jclements3/Erand/ERAND.md

# ERAND — Erard Harp Specifications

Source: https://harpcanada.com/harpmaking/erard.htm (Joseph Jourdain, Josephus Harp Shop, 2019 analysis of a 1901 Paris drawing).

## Historical Background

- **Original drawing**: Paris, 1901, established from photographs of an Erard harp.
- **Analysis author**: Joseph Jourdain — Josephus Harp Shop (2019).
- **Period stringing**: Gut strings (nylon did not exist); compound wire strings beginning at E2 (string #36).

## Range & Configuration

| Property | Value |
|---|---|
| Total strings | 47 |
| Range | C1♭ to G7♯ |
| Middle C | String #26 (C4) |
| Visual markers | C and F strings drawn with thicker lines |

## Overall Dimensions (full-size, scaled from 1901 drawing)

| Dimension | Value |
|---|---|
| Longest string (bass) | 63.189 in |
| Spacing, first to last string | 28.224 in |
| Soundboard length | 50.972 in |
| String angle from soundboard | 34° |
| Drawing scale ratio | 5.35 |

## String Tension Assumptions

- Tensile-strength ratio: **70%** (typical of concert harps, which are known for tight strings).
- Reference string: **0.025" gut**.
- String **#6 (B6♭)** identified as the point of maximum tensile strength.

## Scale-Ratio Sample Calculations (Strings 1–10)

| # | Note | Freq (c/s) | Drawing Length | Theoretical Length | Scale Ratio |
|---|---|---:|---:|---:|---:|
| 1 | G7♭ | 2960.0 | 0.472" | 2.922" | 6.19 |
| 2 | F7♭ | 2637.0 | 0.551" | 3.280" | 5.95 |
| 3 | E7♭ | 2489.0 | 0.629" | 3.475" | 5.52 |
| 4 | D7♭ | 2217.5 | 0.708" | 3.900" | 5.51 |
| 5 | C7♭ | 1975.5 | 0.787" | 4.378" | 5.56 |
| **6** | **B6♭** | **1864.7** | **0.866"** | **4.638"** | **5.35** |
| 7 | A6♭ | 1661.2 | 0.944" | 5.207" | 5.51 |
| 8 | G6♭ | 1480.0 | 1.023" | 5.844" | 5.71 |
| 9 | F6♭ | 1318.5 | 1.141" | 6.560" | 5.75 |
| 10 | E6♭ | 1244.5 | 1.259" | 6.950" | 5.52 |

## Complete Stringing Configuration (47 strings — modern nylon/wire adaptation)

### Upper Register — Strings 1–27 (solid nylon)

| Strings | Diameter |
|---|---|
| 1–7 | 0.025" |
| 8–10 | 0.028" |
| 11 | 0.030" |
| 12–14 | 0.032" |
| 15–18 | 0.036" |
| 19–21 | 0.040" |
| 22–24 | 0.045" |
| 25–27 | 0.050" |

### Middle Register — Strings 28–38 (nylon core with nylon/steel winding)

| Strings | Nylon Core | Wire |
|---|---|---|
| 28–29 | 0.045" | 0.008" |
| 30–31 | 0.050" | 0.008" |
| 32 | 0.050" | 0.013" |
| 33–34 | 0.055" | 0.013" |
| 35–38 | 0.060" | 0.013"–0.022" |

### Lower Register — Strings 39–47 (steel core with bronze winding)

| Strings | Steel Core | Bronze Wrap |
|---|---|---|
| 39 | 0.020" | 0.008" |
| 40 | 0.020" | 0.010" |
| 41 | 0.020" | 0.010" |
| 42 | 0.022" | 0.013" |
| 43 | 0.022" | 0.013" |
| 44–47 | 0.024"–0.026" | 0.013"–0.020" |

## String Tensions

All strings are tuned to the specifications above. Tension spans from **10.976 lb** at string 1 (G7) to **52.693 lb** at string 47 (C1).

## Design Methodology (Five-Step Process)

1. Precise measurement from enlarged drawing (200%+ enlargement recommended).
2. Theoretical stringband calculation for the treble section.
3. Scale-ratio establishment via comparison method.
4. Conversion of all measurements to full size using the identified ratio.
5. Practical string-configuration planning.

### Measurement Precision

A transparent ruler with millimetre or 1/60" graduations plus a magnifying glass achieves precision of about **0.2 mm (0.008")**.

## Folk-Harp Adaptation

A 36-string folk version covering **C2 to C7** can be produced by:

- Removing the first 4 and last 7 strings.
- Converting the instrument entirely to nylon strings.
- Applying a **5.612% reduction factor** for natural notes.

## References Cited

- Melville Clark, *How to Play the Harp*.
- Roslyn Rensch, *Harps & Harpists*.
