jclements3/Erand/erand47.FCStd

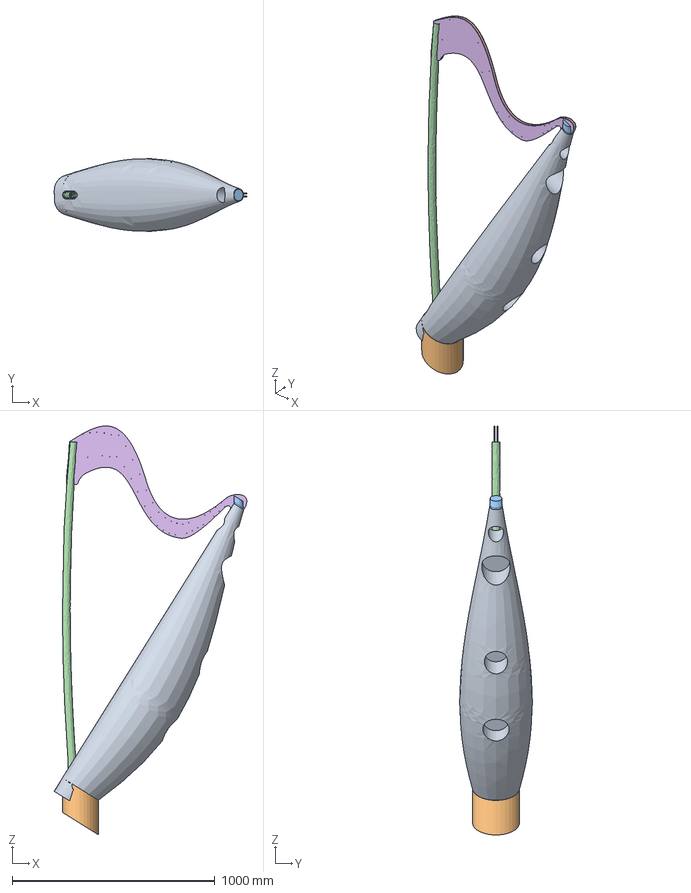
[picture p1: CAD file, 2026-04-25]
erand47.FCStd
950.1 x 359.6 x 2017.2 mm
Chamber
BasePlug
Shoulder
Column
NeckPlate_pz
NeckPlate_mz
