jclements3/Erand/soundbox/mold/individual_slabs/slab_43.dxf

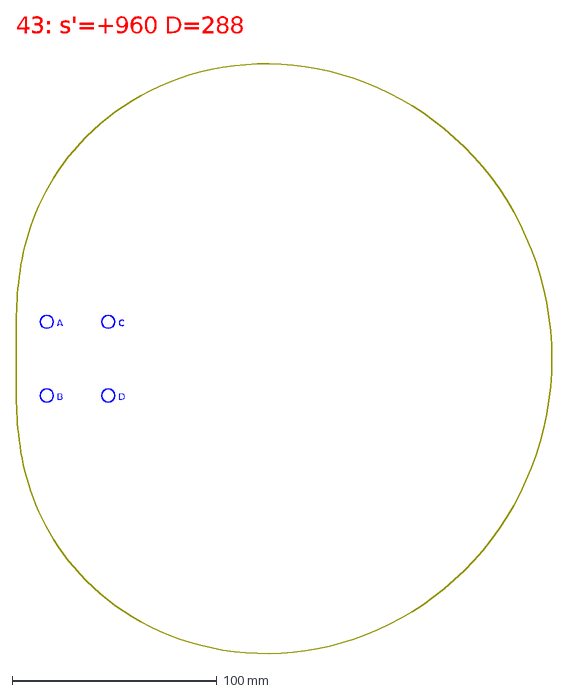
[picture p2: CAD file, 2026-04-20]
soundbox/mold/individual_slabs/slab_43.dxf
43: s'=+960 D=288
A
B
C
D
