jclements3/Erand/erand.dxf

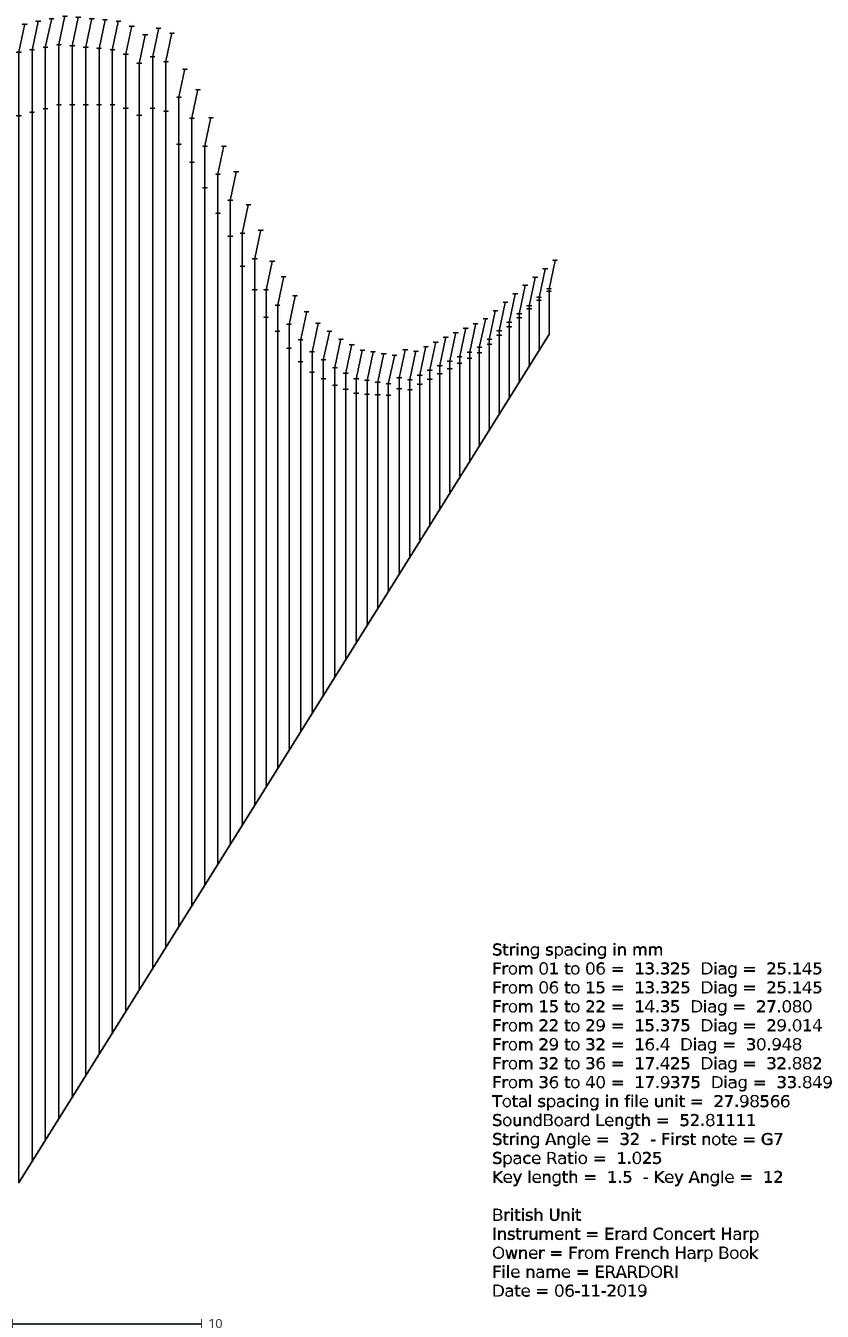
[picture p3: CAD file, 2026-04-19]
erand.dxf
String spacing in mm
From 01 to 06 = 13.325 Diag = 25.145
From 06 to 15 = 13.325 Diag = 25.145
From 15 to 22 = 14.35 Diag = 27.080
From 22 to 29 = 15.375 Diag = 29.014
From 29 to 32 = 16.4 Diag = 30.948
From 32 to 36 = 17.425 Diag = 32.882
From 36 to 40 = 17.9375 Diag = 33.849
Total spacing in file unit = 27.98566
SoundBoard Length = 52.81111
String Angle = 32 - First note = G7
Space Ratio = 1.025
Key length = 1.5 - Key Angle = 12
British Unit
Instrument = Erard Concert Harp
Owner = From French Harp Book
File name = ERARDORI
Date = 06-11-2019
