jclements3/Erand/soundbox/mold/individual_slabs/slab_67.dxf

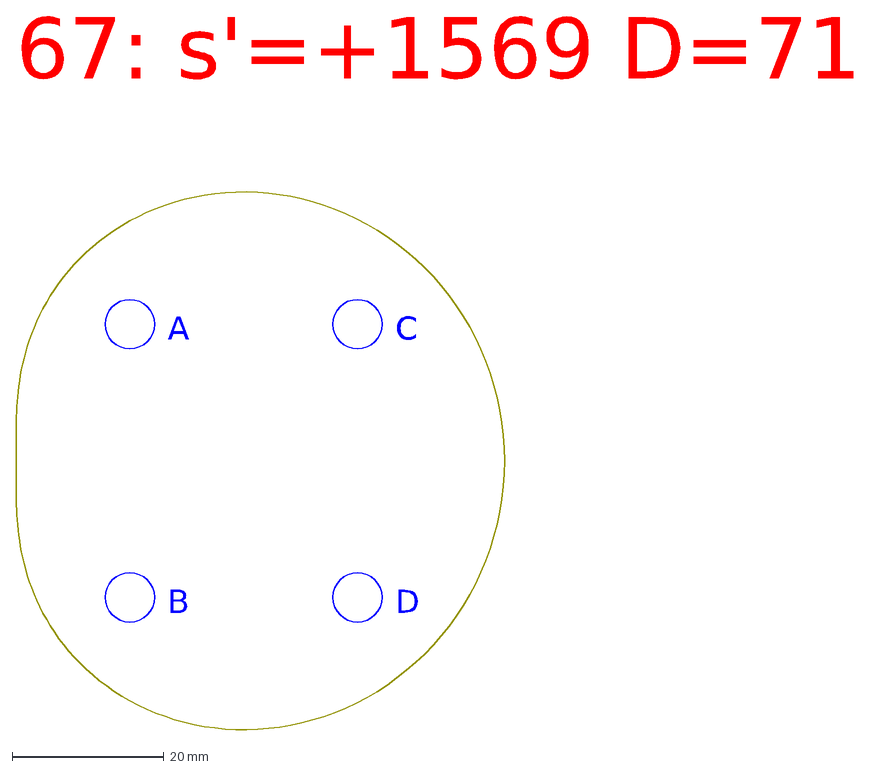
[picture p4: CAD file, 2026-04-20]
soundbox/mold/individual_slabs/slab_67.dxf
67: s'=+1569 D=71
A
B
C
D
