jclements3/Erand/soundbox/mold/individual_slabs/slab_23.dxf

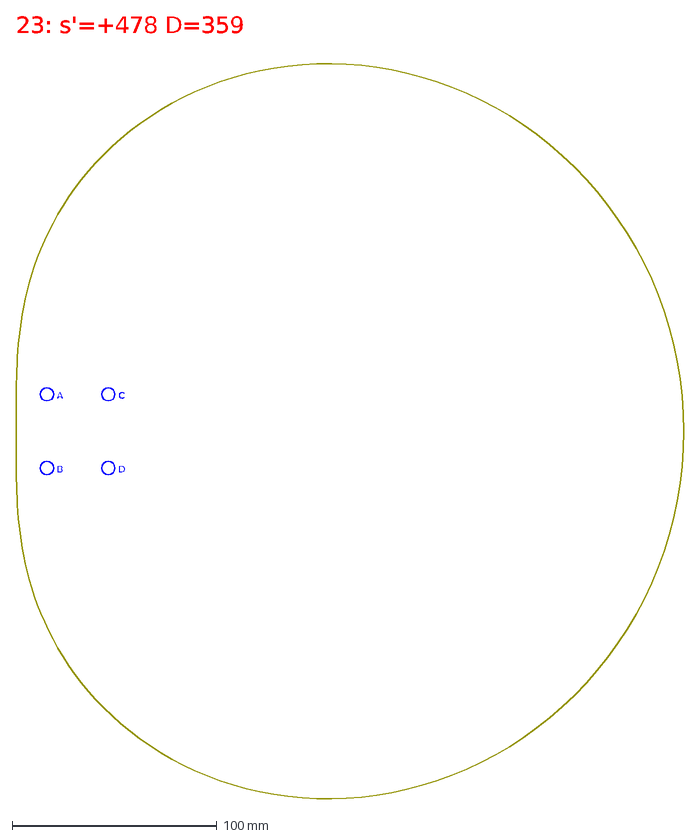
[picture p5: CAD file, 2026-04-20]
soundbox/mold/individual_slabs/slab_23.dxf
23: s'=+478 D=359
A
B
C
D
