jclements3/Erand/soundbox/mold/individual_slabs/slab_39.dxf

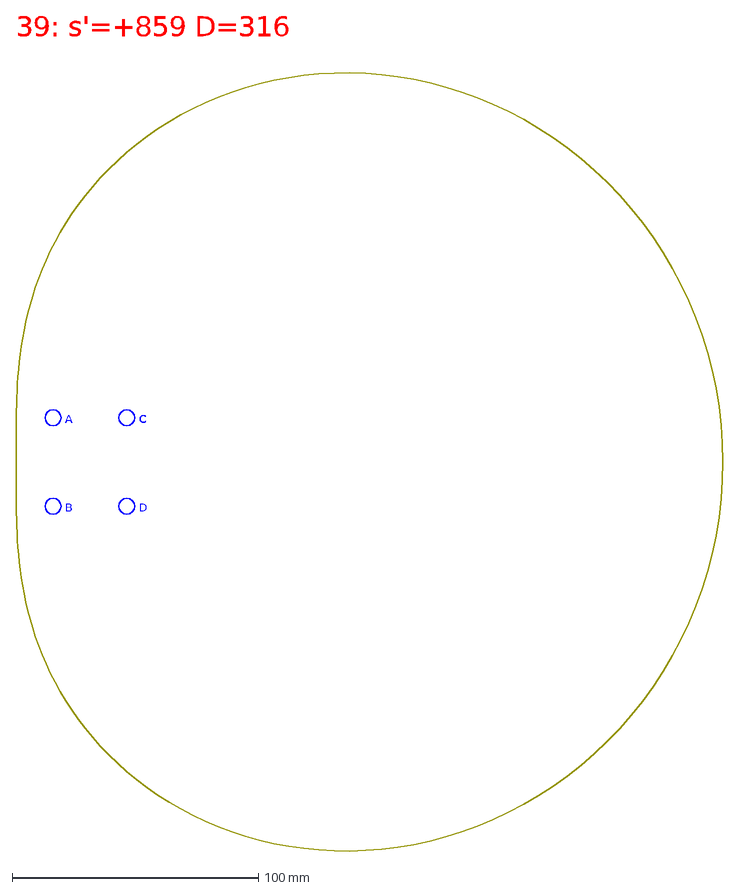
[picture p6: CAD file, 2026-04-20]
soundbox/mold/individual_slabs/slab_39.dxf
39: s'=+859 D=316
A
B
C
D
