jclements3/Erand/soundbox/mold/individual_slabs/slab_49.dxf

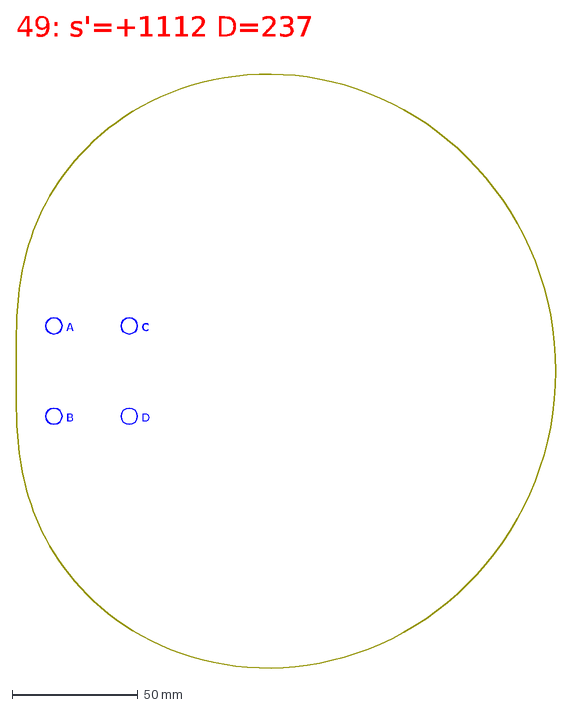
[picture p7: CAD file, 2026-04-20]
soundbox/mold/individual_slabs/slab_49.dxf
49: s'=+1112 D=237
A
B
C
D
