jclements3/Erand/soundbox/mold/individual_slabs/slab_32.dxf

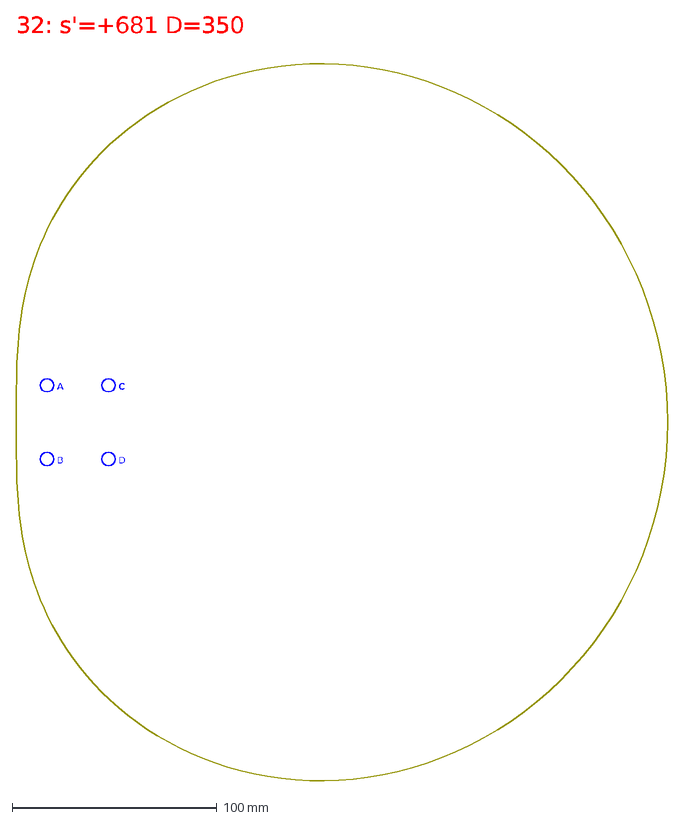
[picture p8: CAD file, 2026-04-20]
soundbox/mold/individual_slabs/slab_32.dxf
32: s'=+681 D=350
A
B
C
D
