jclements3/Erand/soundbox/mold/individual_slabs/slab_41.dxf

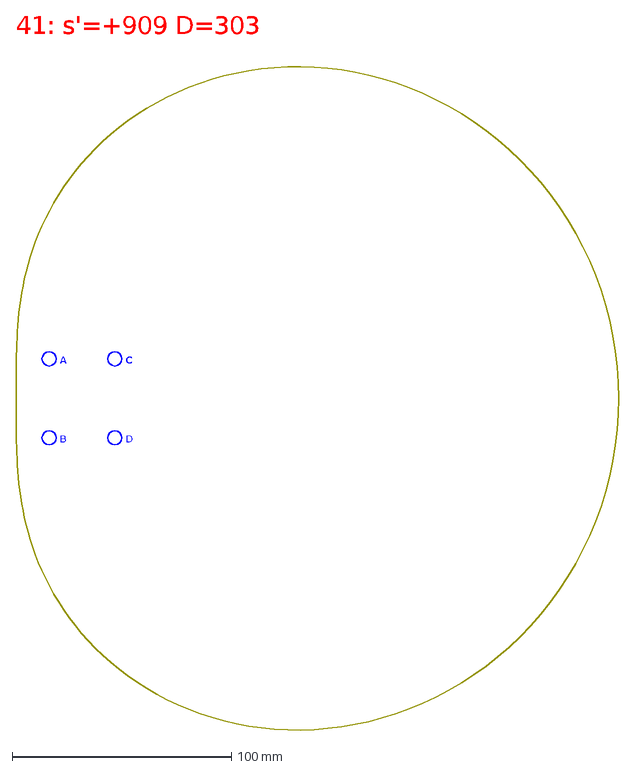
[picture p9: CAD file, 2026-04-20]
soundbox/mold/individual_slabs/slab_41.dxf
41: s'=+909 D=303
A
B
C
D
