jclements3/Erand/soundbox/mold/individual_slabs/slab_00.dxf

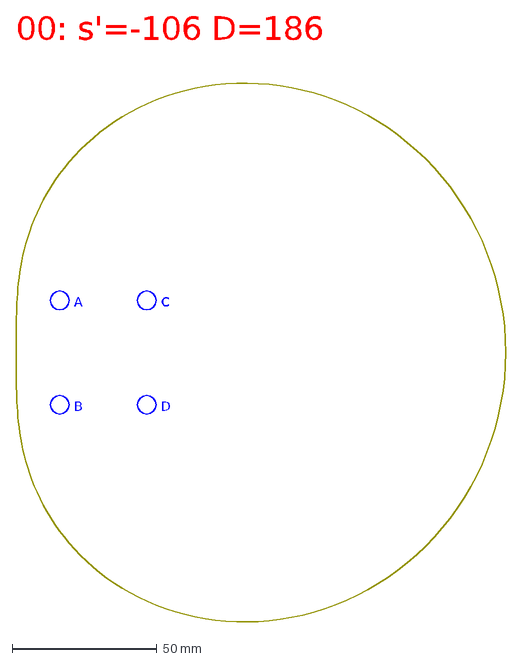
[picture p10: CAD file, 2026-04-20]
soundbox/mold/individual_slabs/slab_00.dxf
00: s'=-106 D=186
A
B
C
D
