jclements3/Erand/soundbox/mold/individual_slabs/slab_37.dxf

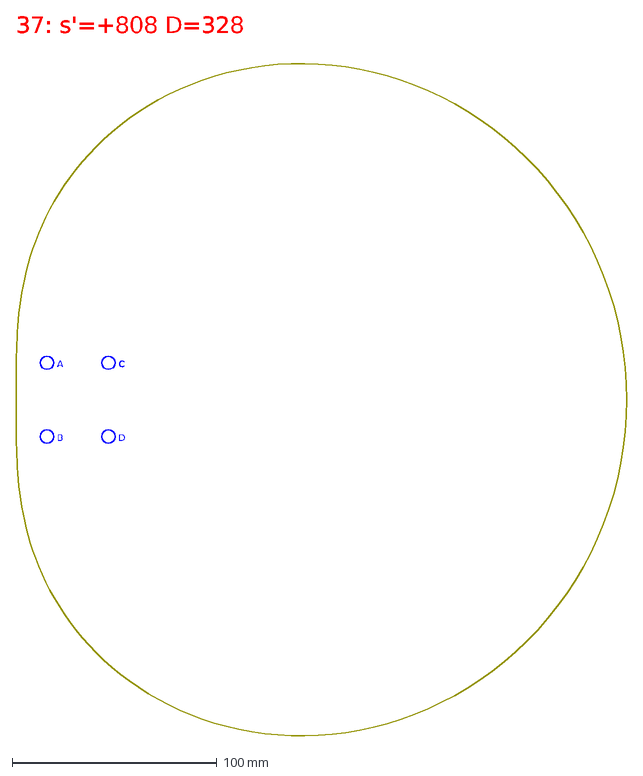
[picture p11: CAD file, 2026-04-20]
soundbox/mold/individual_slabs/slab_37.dxf
37: s'=+808 D=328
A
B
C
D
