jclements3/Erand/soundbox/mold/individual_slabs/slab_56.dxf

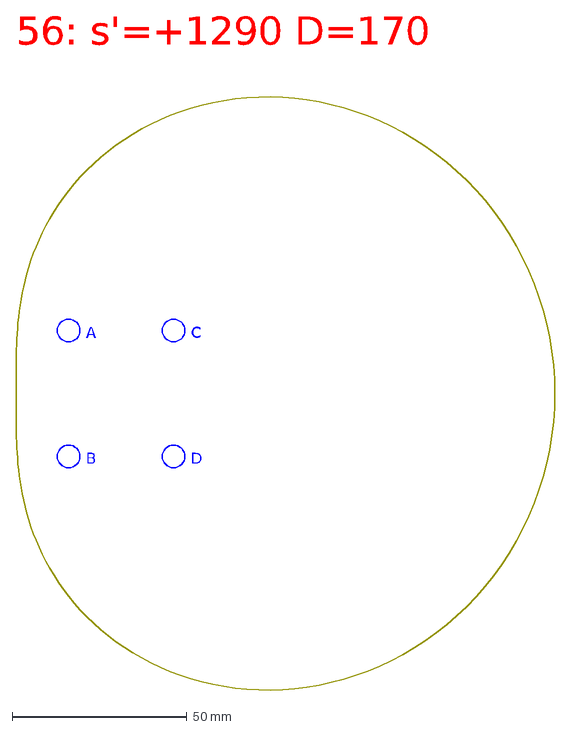
[picture p12: CAD file, 2026-04-20]
soundbox/mold/individual_slabs/slab_56.dxf
56: s'=+1290 D=170
A
B
C
D
