jclements3/Erand/soundbox/mold/individual_slabs/slab_50.dxf

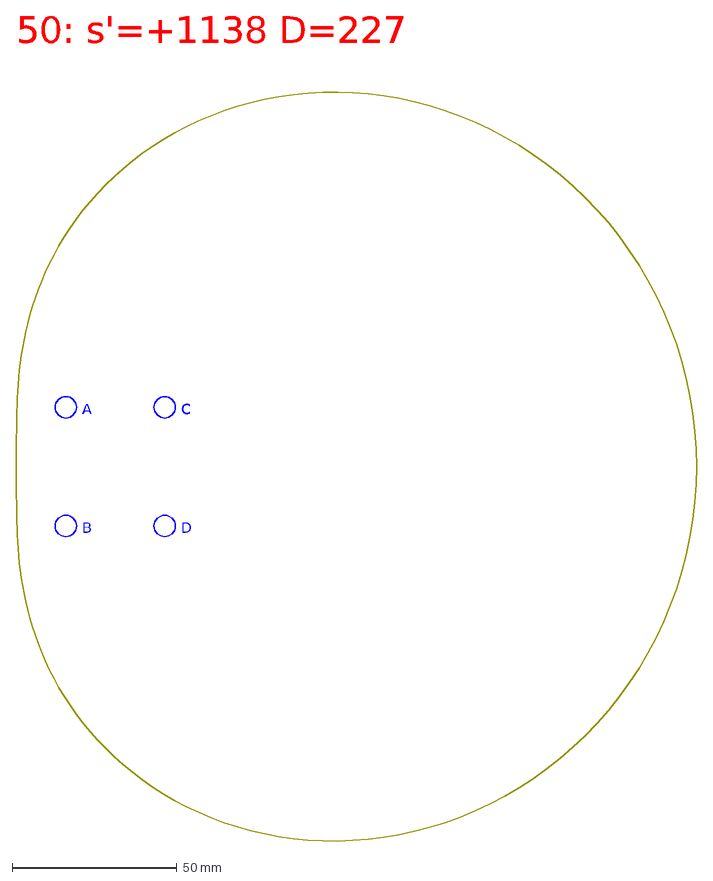
[picture p13: CAD file, 2026-04-20]
soundbox/mold/individual_slabs/slab_50.dxf
50: s'=+1138 D=227
A
B
C
D
