jclements3/Erand/soundbox/mold/individual_slabs/slab_48.dxf

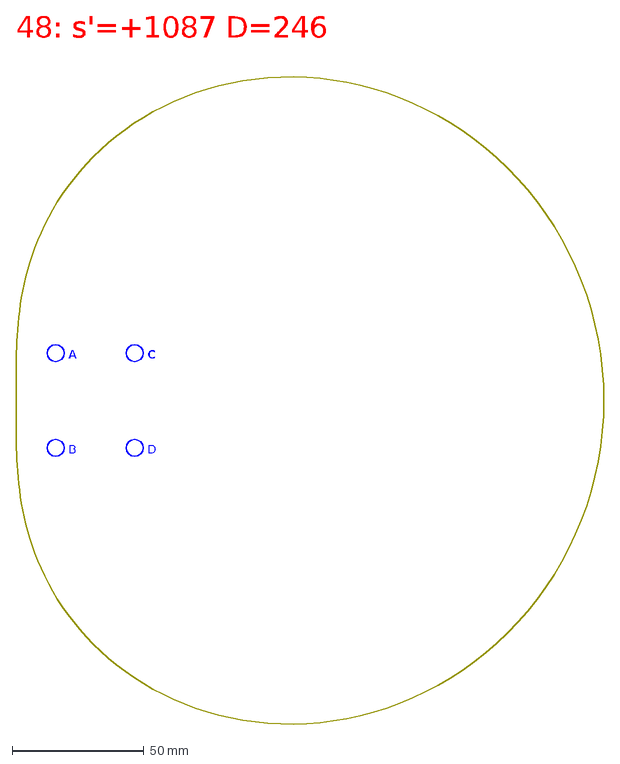
[picture p14: CAD file, 2026-04-20]
soundbox/mold/individual_slabs/slab_48.dxf
48: s'=+1087 D=246
A
B
C
D
