jclements3/Erand/soundbox/mold/individual_slabs/slab_33.dxf

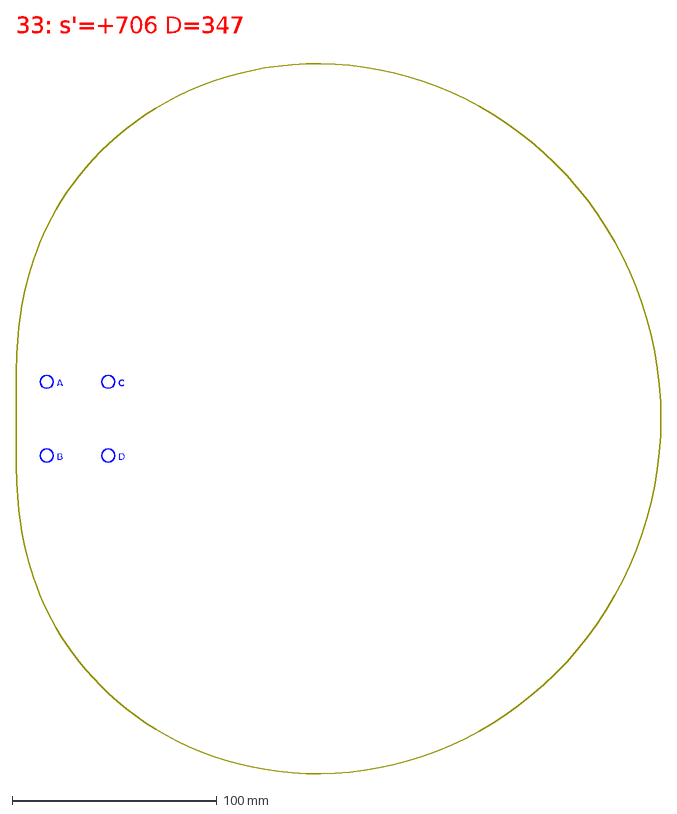
[picture p15: CAD file, 2026-04-20]
soundbox/mold/individual_slabs/slab_33.dxf
33: s'=+706 D=347
A
B
C
D
