jclements3/Erand/soundbox/mold/individual_slabs/slab_17.dxf

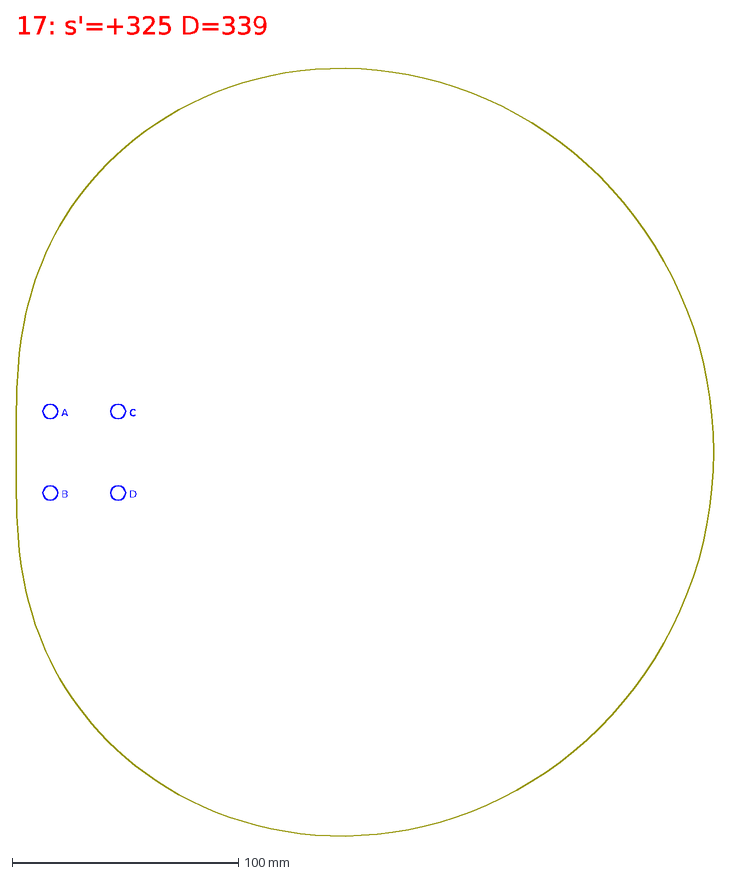
[picture p16: CAD file, 2026-04-20]
soundbox/mold/individual_slabs/slab_17.dxf
17: s'=+325 D=339
A
B
C
D
