jclements3/Erand/soundbox/mold/individual_slabs/slab_13.dxf

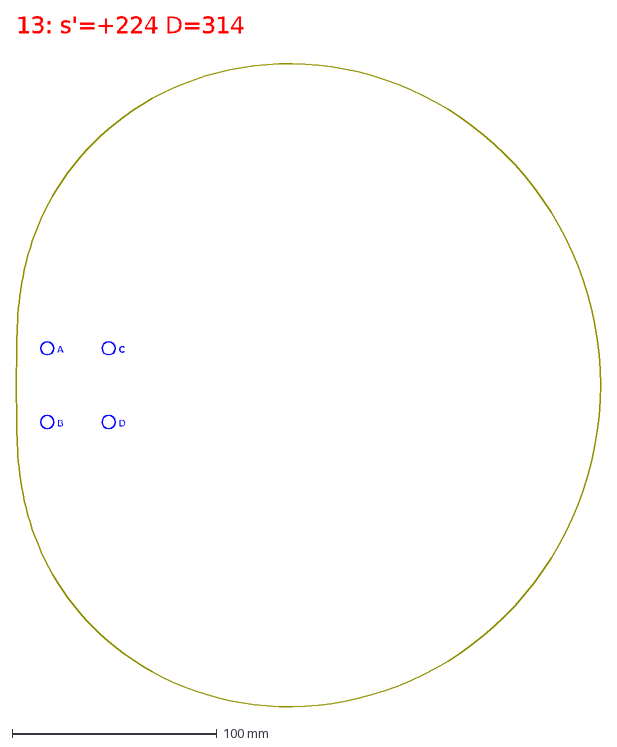
[picture p17: CAD file, 2026-04-20]
soundbox/mold/individual_slabs/slab_13.dxf
13: s'=+224 D=314
A
B
C
D
