jclements3/Erand/soundbox/mold/individual_slabs/slab_28.dxf

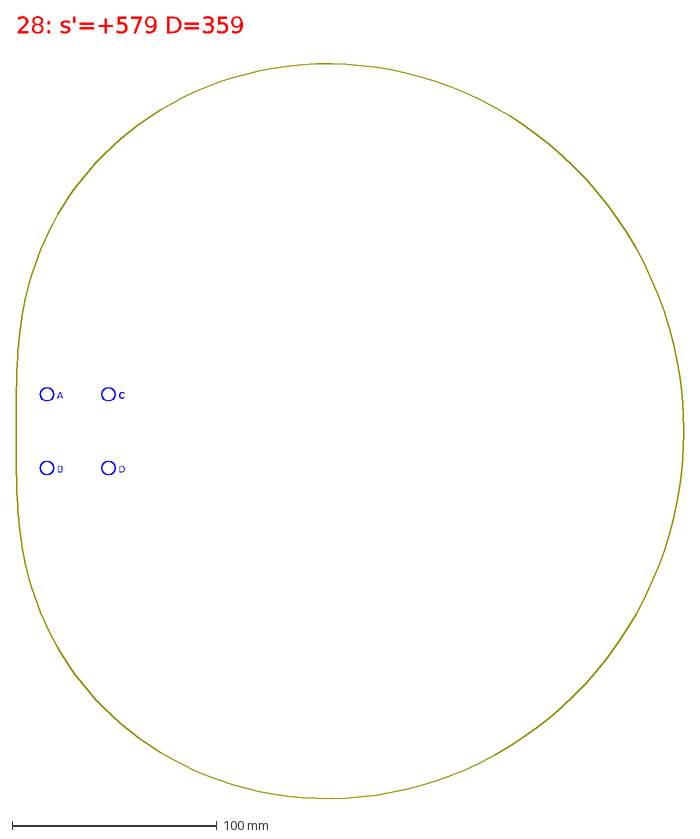
[picture p18: CAD file, 2026-04-20]
soundbox/mold/individual_slabs/slab_28.dxf
28: s'=+579 D=359
A
B
C
D
