jclements3/Erand/soundbox/mold/individual_slabs/slab_61.dxf

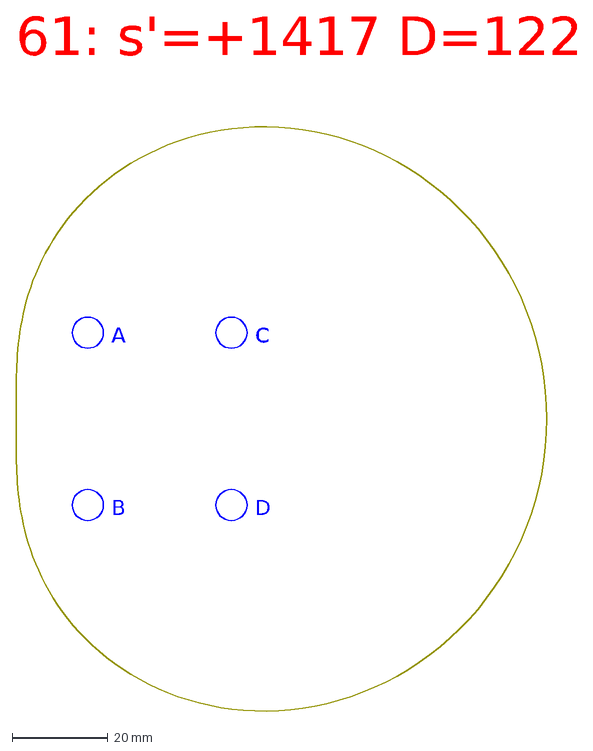
[picture p19: CAD file, 2026-04-20]
soundbox/mold/individual_slabs/slab_61.dxf
61: s'=+1417 D=122
A
B
C
D
