jclements3/Erand/soundbox/mold/individual_slabs/slab_07.dxf

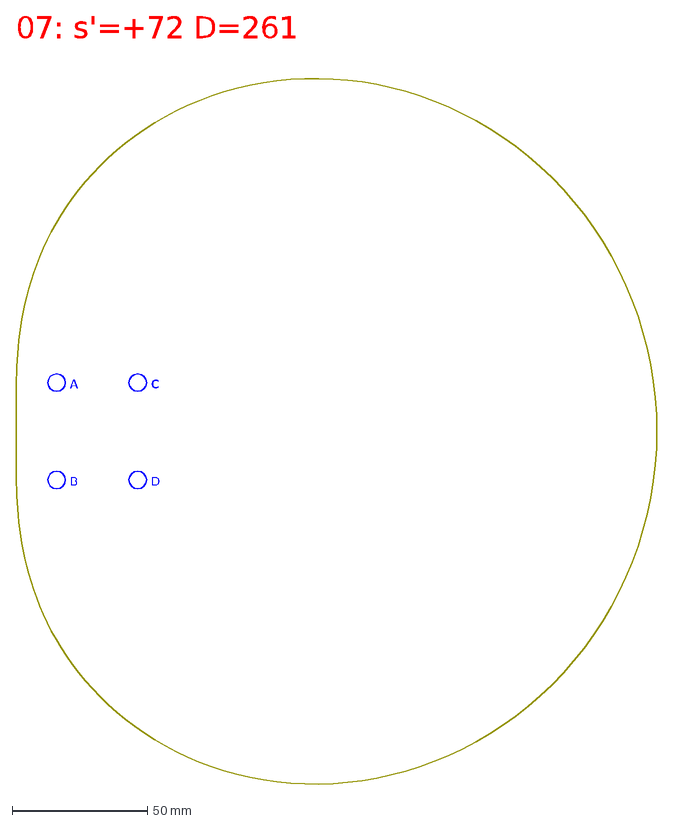
[picture p20: CAD file, 2026-04-20]
soundbox/mold/individual_slabs/slab_07.dxf
07: s'=+72 D=261
A
B
C
D
