jclements3/Erand/soundbox/mold/individual_slabs/slab_25.dxf

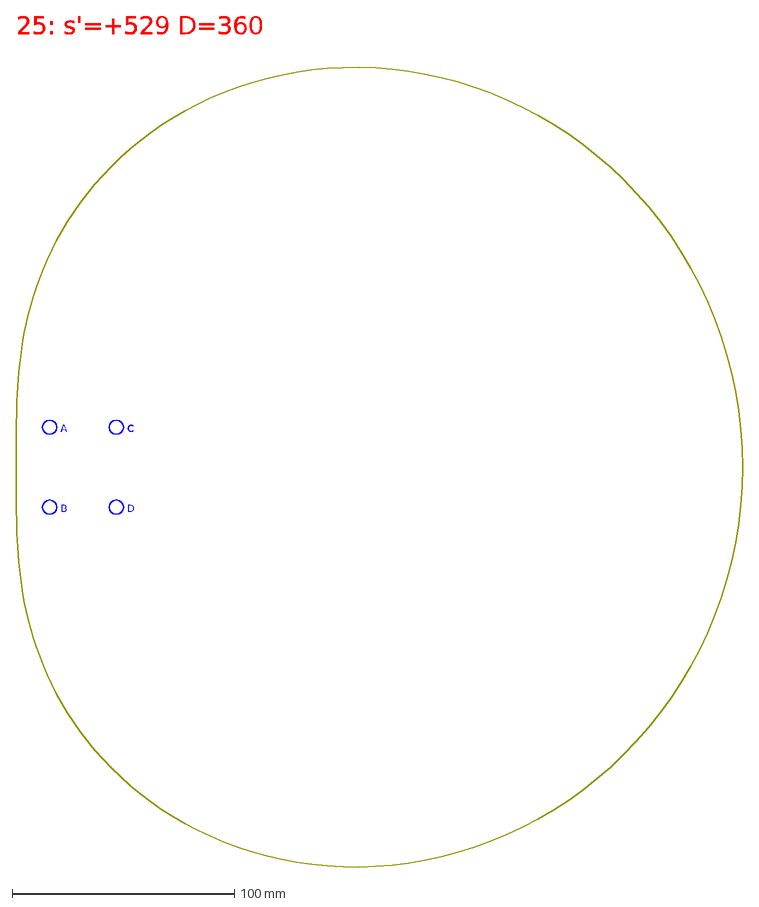
[picture p21: CAD file, 2026-04-20]
soundbox/mold/individual_slabs/slab_25.dxf
25: s'=+529 D=360
A
B
C
D
