jclements3/Erand/soundbox/mold/individual_slabs/slab_12.dxf

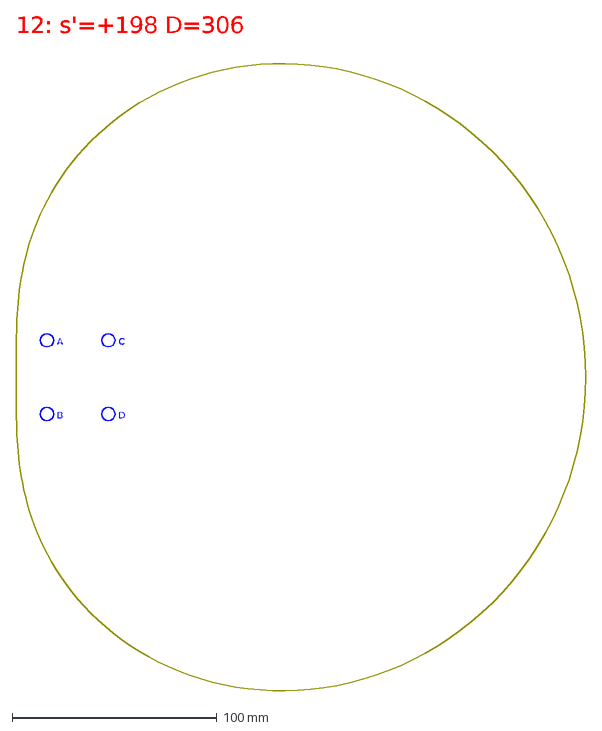
[picture p22: CAD file, 2026-04-20]
soundbox/mold/individual_slabs/slab_12.dxf
12: s'=+198 D=306
A
B
C
D
