jclements3/Erand/soundbox/mold/individual_slabs/slab_44.dxf

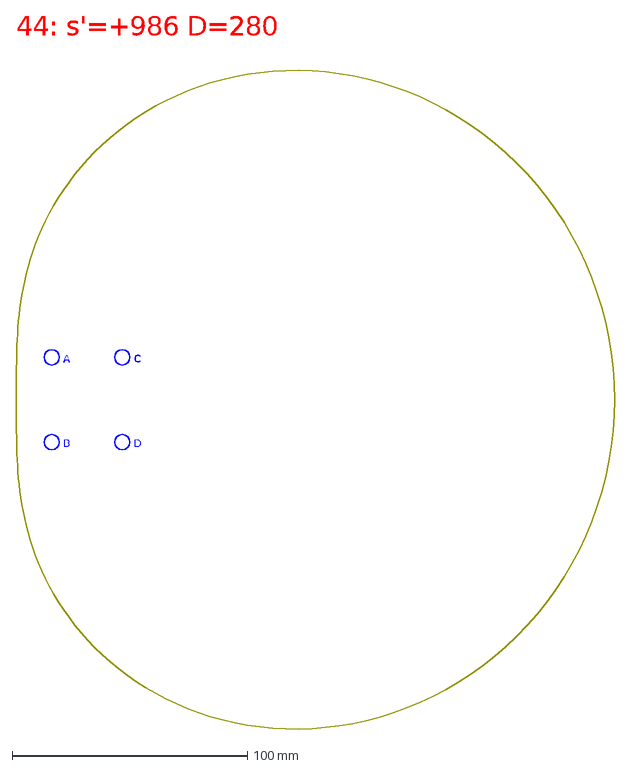
[picture p23: CAD file, 2026-04-20]
soundbox/mold/individual_slabs/slab_44.dxf
44: s'=+986 D=280
A
B
C
D
