jclements3/Erand/soundbox/mold/individual_slabs/slab_20.dxf

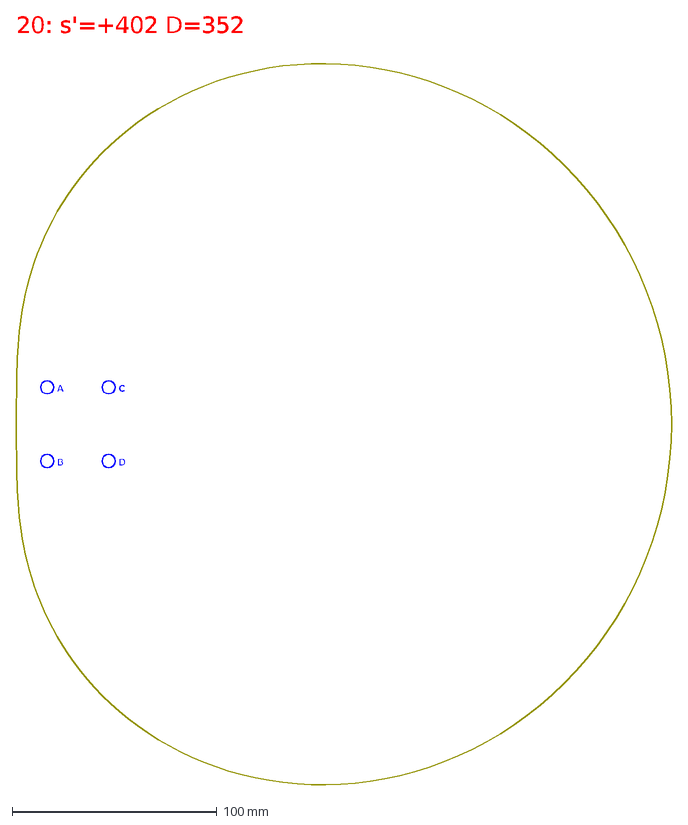
[picture p24: CAD file, 2026-04-20]
soundbox/mold/individual_slabs/slab_20.dxf
20: s'=+402 D=352
A
B
C
D
