jclements3/Erand/soundbox/mold/individual_slabs/slab_21.dxf

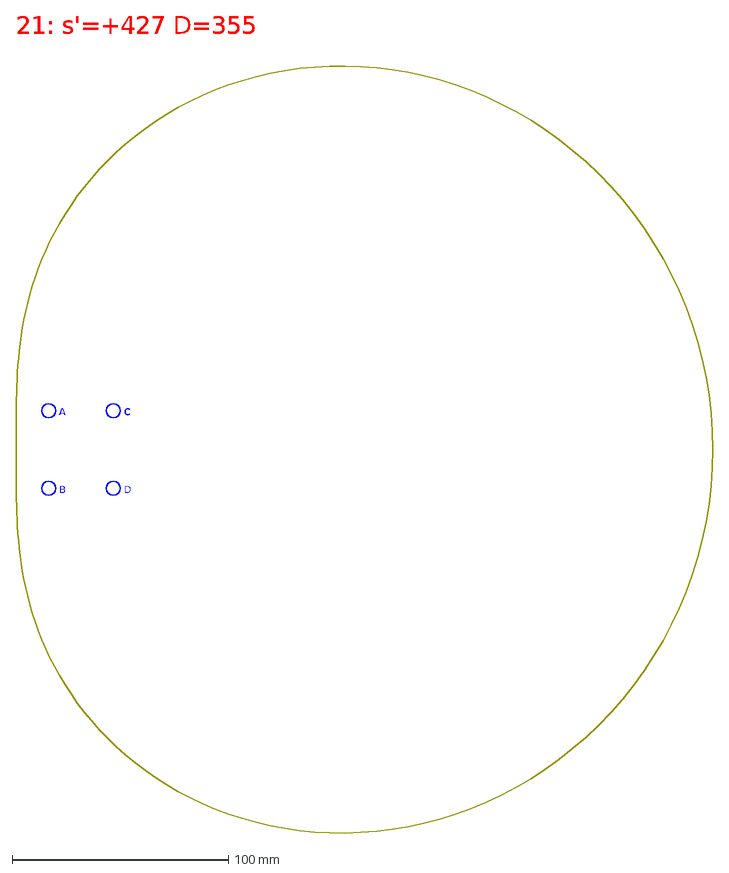
[picture p25: CAD file, 2026-04-20]
soundbox/mold/individual_slabs/slab_21.dxf
21: s'=+427 D=355
A
B
C
D
