jclements3/Erand/soundbox/mold/individual_slabs/slab_34.dxf

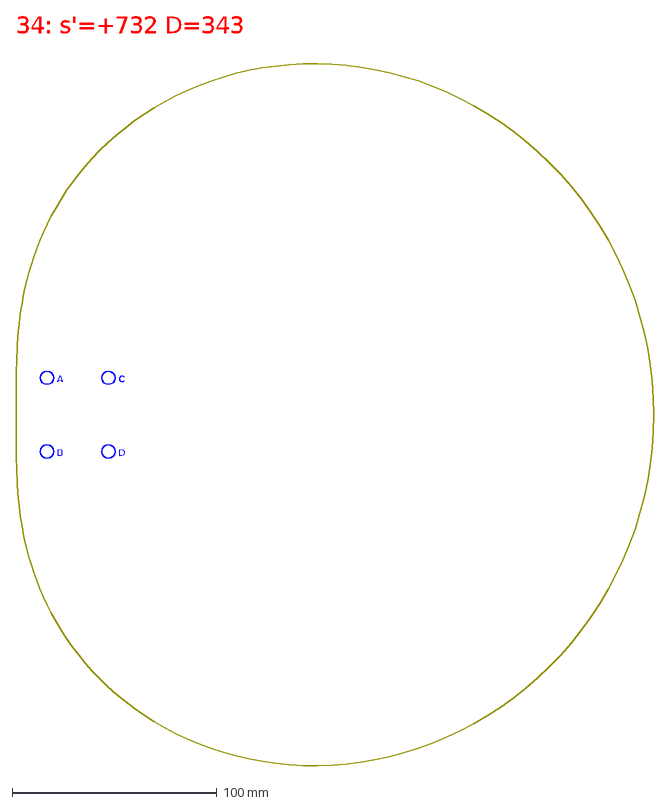
[picture p26: CAD file, 2026-04-20]
soundbox/mold/individual_slabs/slab_34.dxf
34: s'=+732 D=343
A
B
C
D
