jclements3/Erand/soundbox/mold/individual_slabs/slab_57.dxf

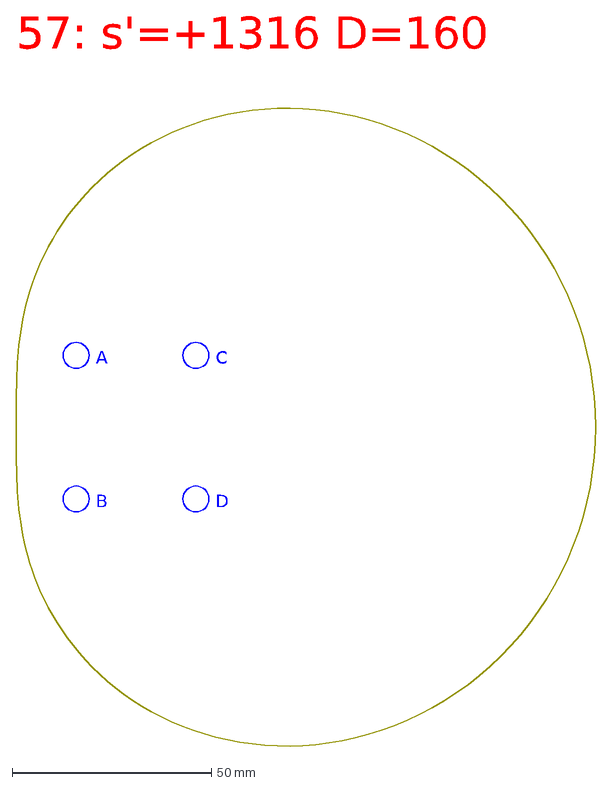
[picture p27: CAD file, 2026-04-20]
soundbox/mold/individual_slabs/slab_57.dxf
57: s'=+1316 D=160
A
B
C
D
