jclements3/Erand/soundbox/mold/individual_slabs/slab_66.dxf

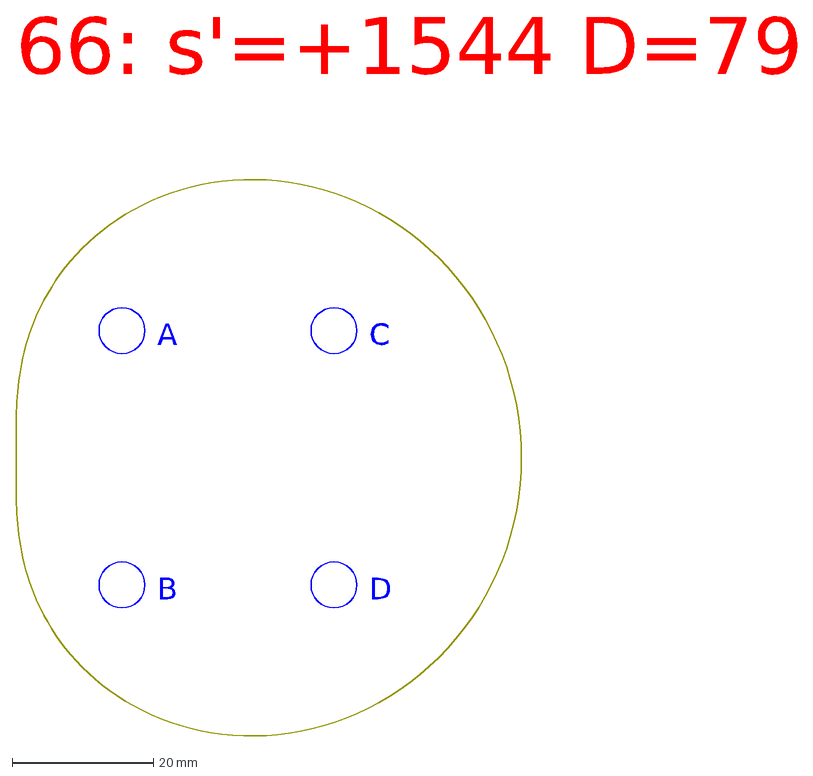
[picture p28: CAD file, 2026-04-20]
soundbox/mold/individual_slabs/slab_66.dxf
66: s'=+1544 D=79
A
B
C
D
