jclements3/Erand/soundbox/mold/individual_slabs/slab_04.dxf

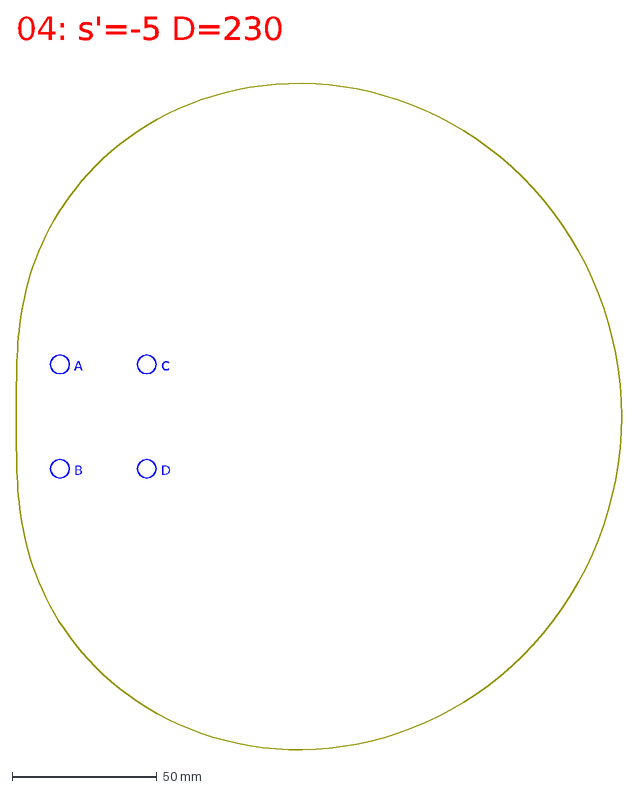
[picture p29: CAD file, 2026-04-20]
soundbox/mold/individual_slabs/slab_04.dxf
04: s'=-5 D=230
A
B
C
D
