jclements3/Erand/soundbox/mold/individual_slabs/slab_29.dxf

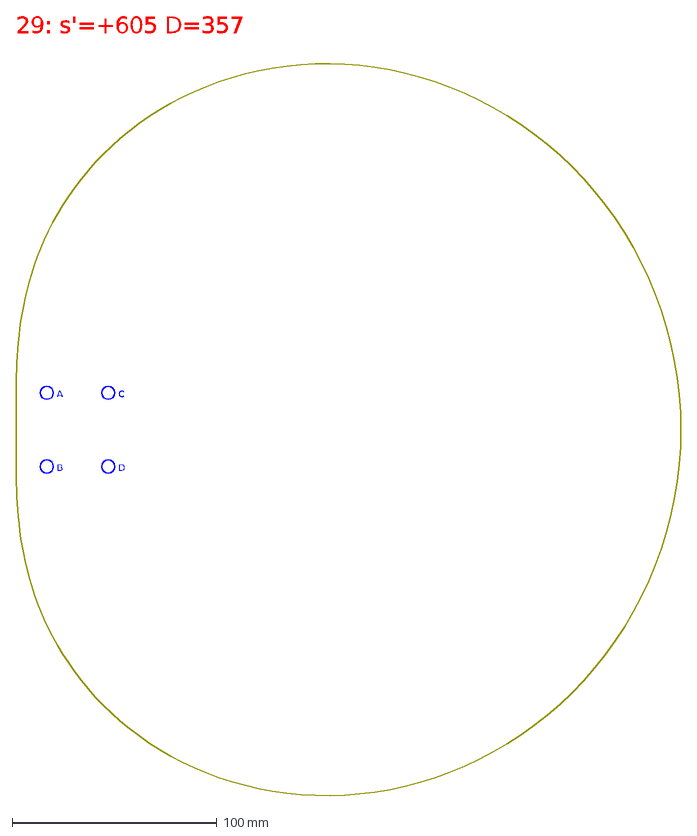
[picture p30: CAD file, 2026-04-20]
soundbox/mold/individual_slabs/slab_29.dxf
29: s'=+605 D=357
A
B
C
D
