jclements3/Erand/soundbox/mold/individual_slabs/slab_06.dxf

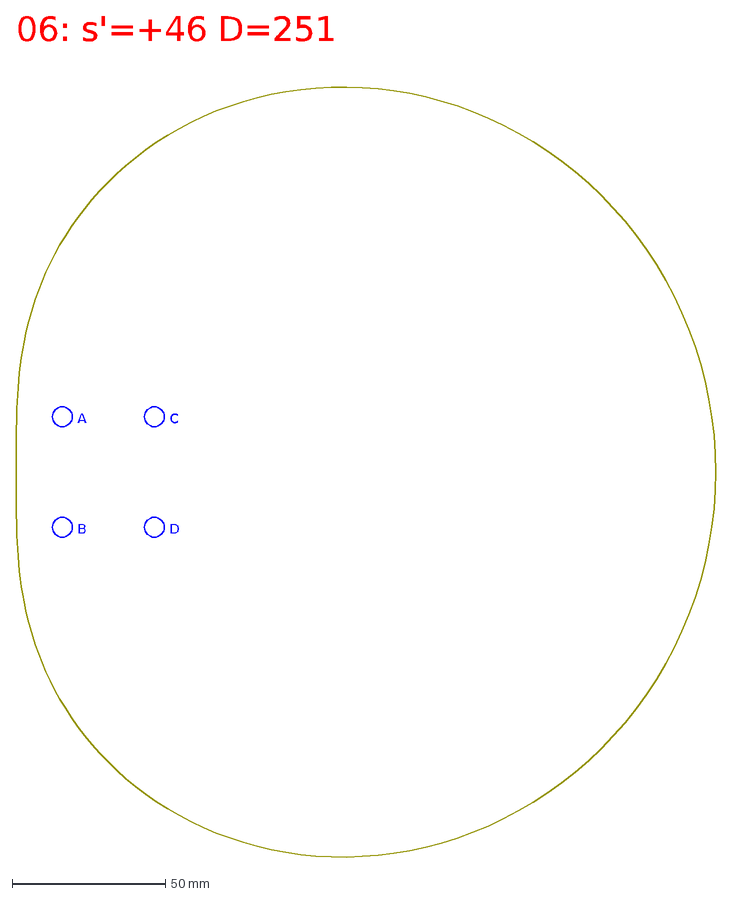
[picture p31: CAD file, 2026-04-20]
soundbox/mold/individual_slabs/slab_06.dxf
06: s'=+46 D=251
A
B
C
D
