jclements3/Erand/soundbox/mold/individual_slabs/slab_10.dxf

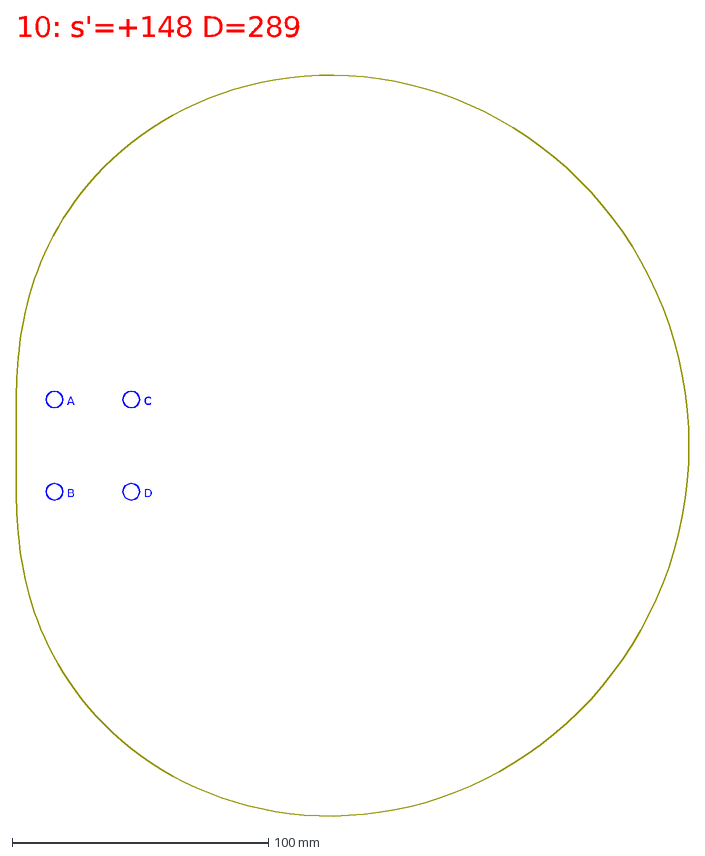
[picture p32: CAD file, 2026-04-20]
soundbox/mold/individual_slabs/slab_10.dxf
10: s'=+148 D=289
A
B
C
D
