jclements3/Erand/soundbox/mold/individual_slabs/slab_27.dxf

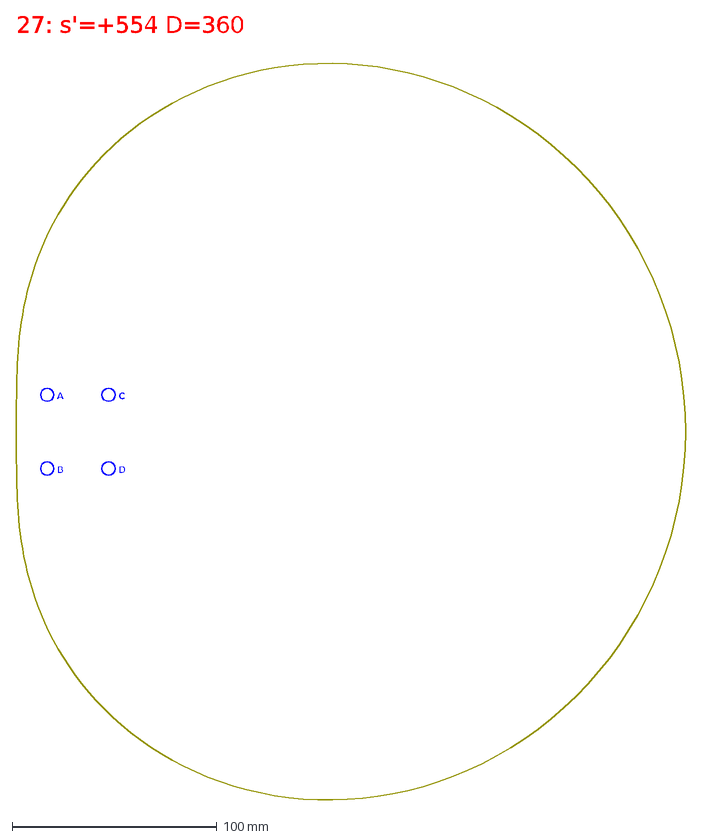
[picture p33: CAD file, 2026-04-20]
soundbox/mold/individual_slabs/slab_27.dxf
27: s'=+554 D=360
A
B
C
D
