jclements3/Erand/soundbox/mold/individual_slabs/slab_05.dxf

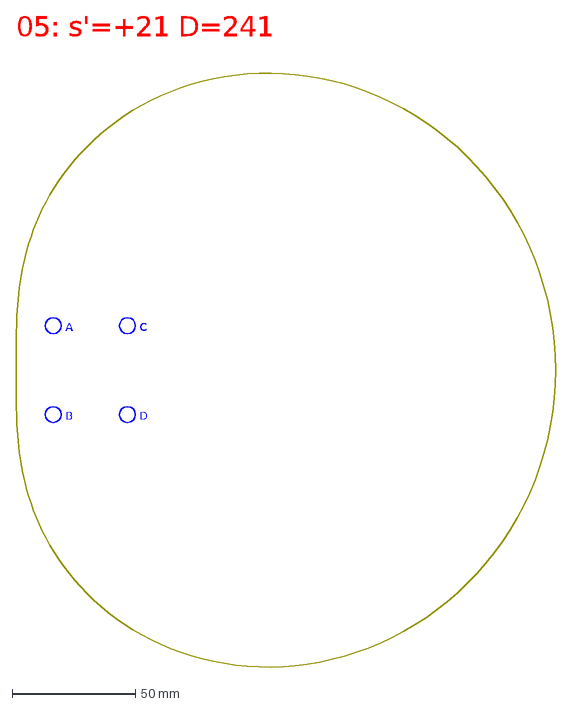
[picture p34: CAD file, 2026-04-20]
soundbox/mold/individual_slabs/slab_05.dxf
05: s'=+21 D=241
A
B
C
D
