jclements3/Erand/soundbox/mold/individual_slabs/slab_26.dxf

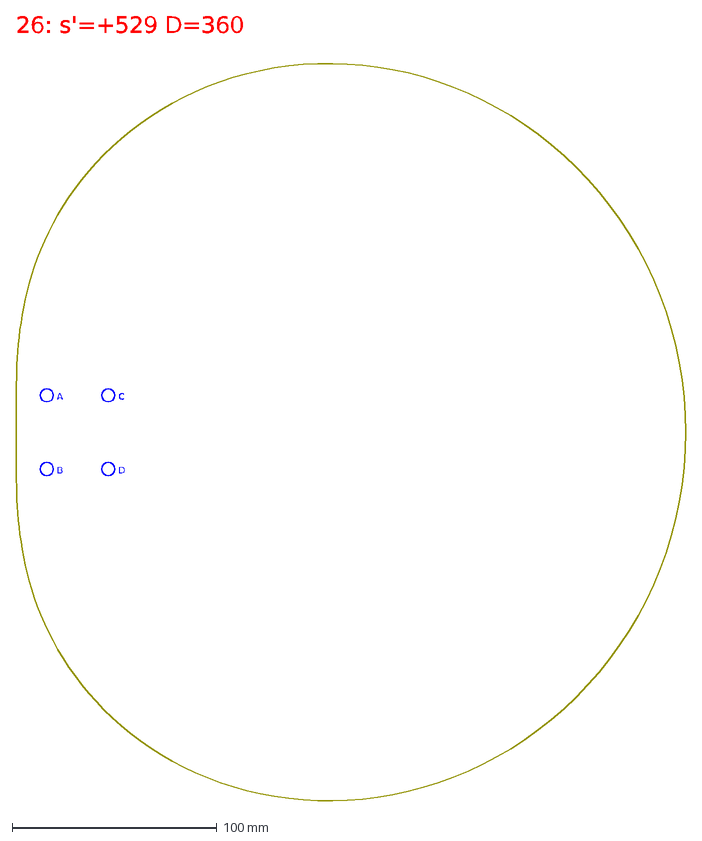
[picture p35: CAD file, 2026-04-20]
soundbox/mold/individual_slabs/slab_26.dxf
26: s'=+529 D=360
A
B
C
D
