jclements3/Erand/soundbox/mold/individual_slabs/slab_64.dxf

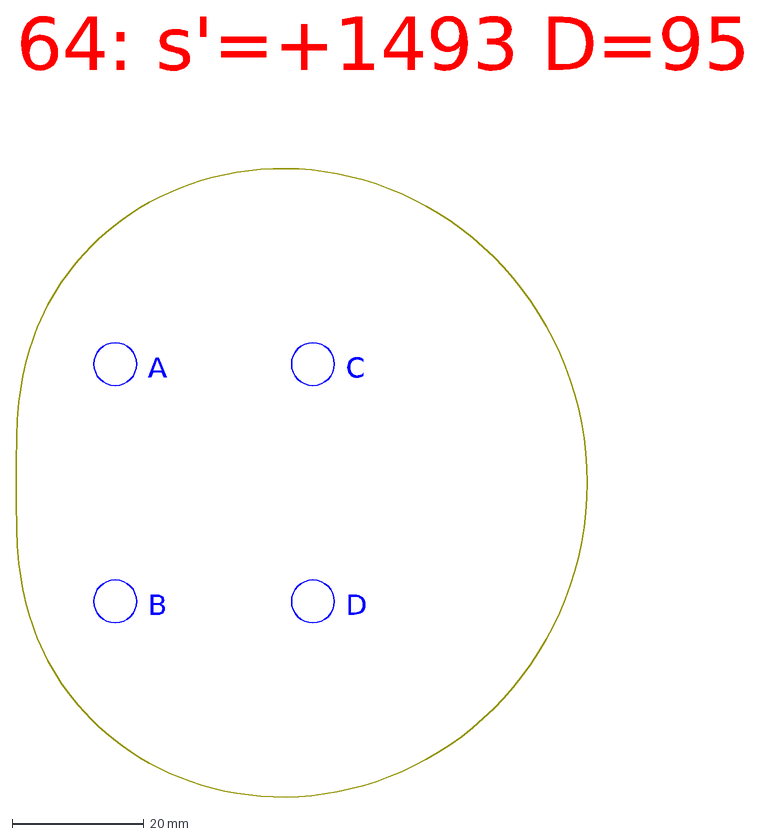
[picture p36: CAD file, 2026-04-20]
soundbox/mold/individual_slabs/slab_64.dxf
64: s'=+1493 D=95
A
B
C
D
