jclements3/Erand/soundbox/mold/individual_slabs/slab_63.dxf

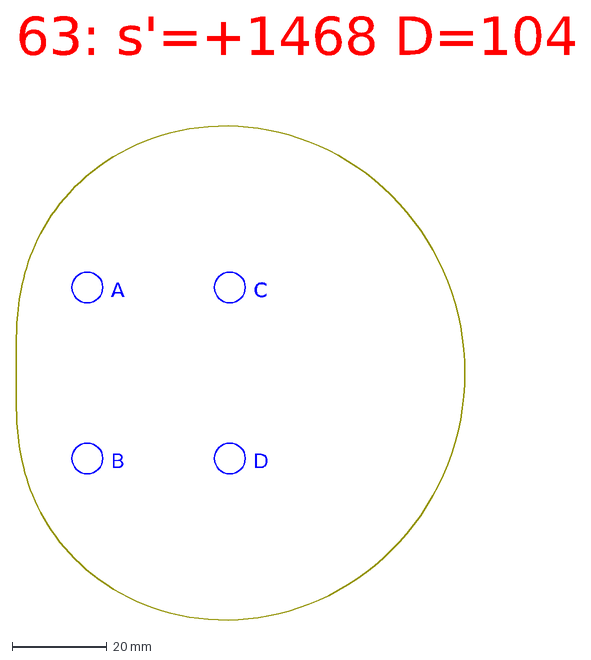
[picture p37: CAD file, 2026-04-20]
soundbox/mold/individual_slabs/slab_63.dxf
63: s'=+1468 D=104
A
B
C
D
