jclements3/Erand/soundbox/mold/individual_slabs/slab_01.dxf

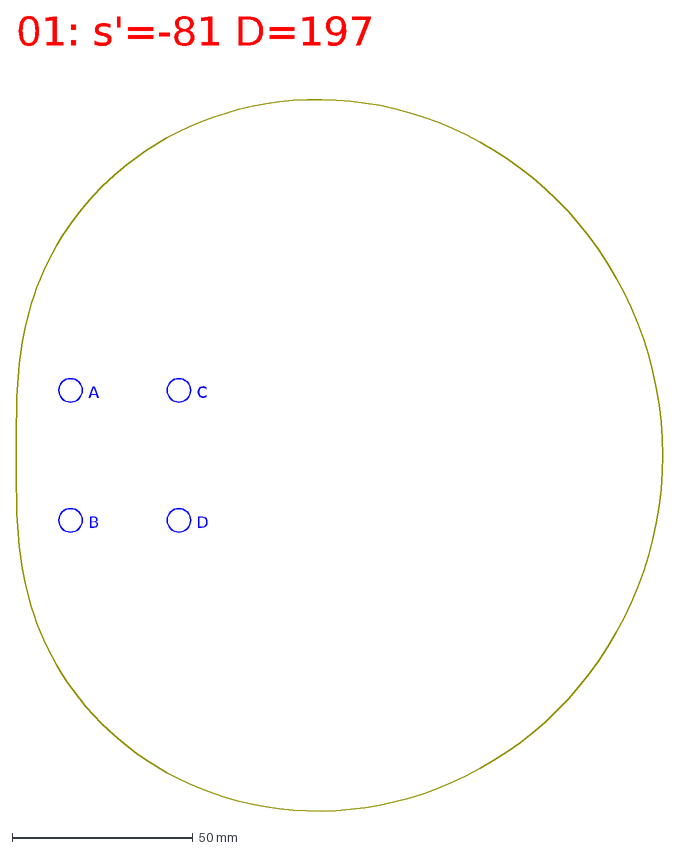
[picture p38: CAD file, 2026-04-20]
soundbox/mold/individual_slabs/slab_01.dxf
01: s'=-81 D=197
A
B
C
D
