jclements3/Erand/soundbox/mold/individual_slabs/slab_03.dxf

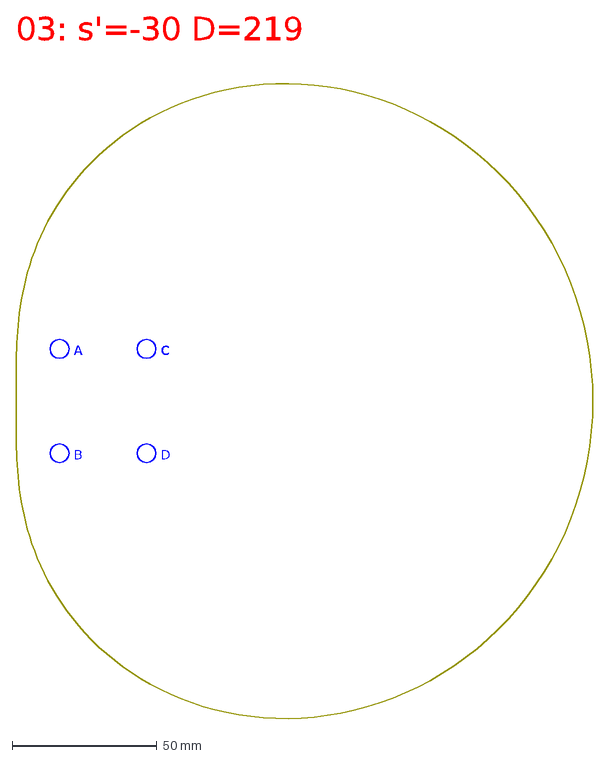
[picture p39: CAD file, 2026-04-20]
soundbox/mold/individual_slabs/slab_03.dxf
03: s'=-30 D=219
A
B
C
D
