jclements3/Erand/soundbox/mold/individual_slabs/slab_19.dxf

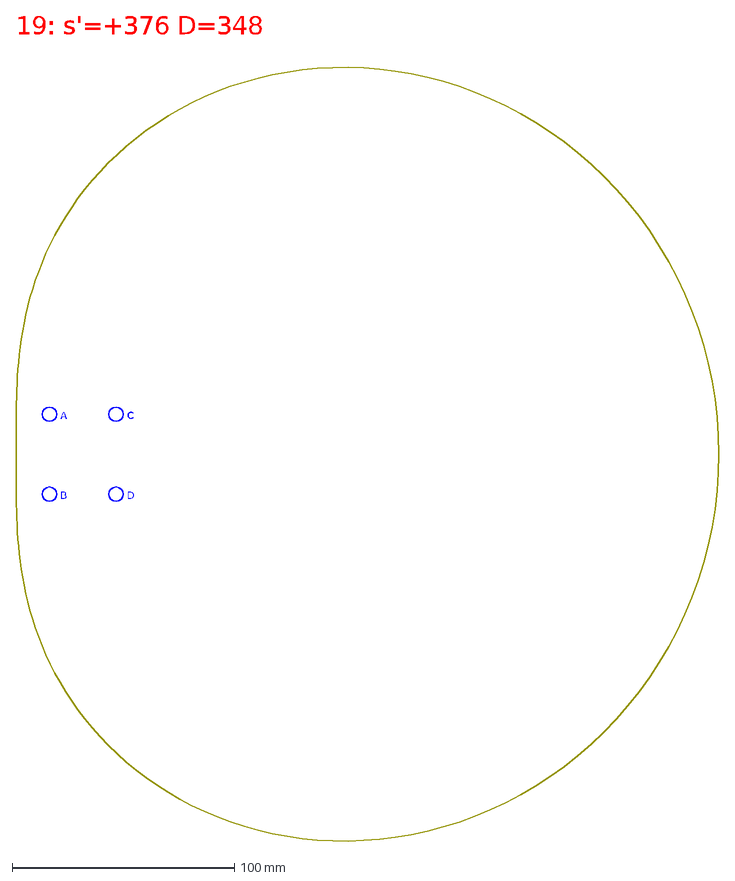
[picture p40: CAD file, 2026-04-20]
soundbox/mold/individual_slabs/slab_19.dxf
19: s'=+376 D=348
A
B
C
D
