jclements3/Erand/soundbox/mold/individual_slabs/slab_30.dxf

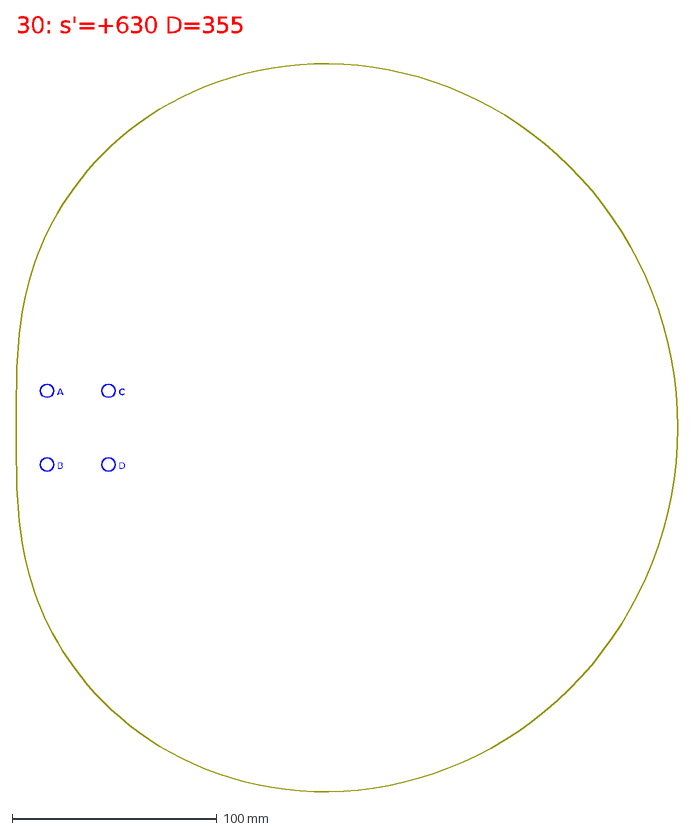
[picture p41: CAD file, 2026-04-20]
soundbox/mold/individual_slabs/slab_30.dxf
30: s'=+630 D=355
A
B
C
D
