jclements3/Erand/soundbox/mold/individual_slabs/slab_16.dxf

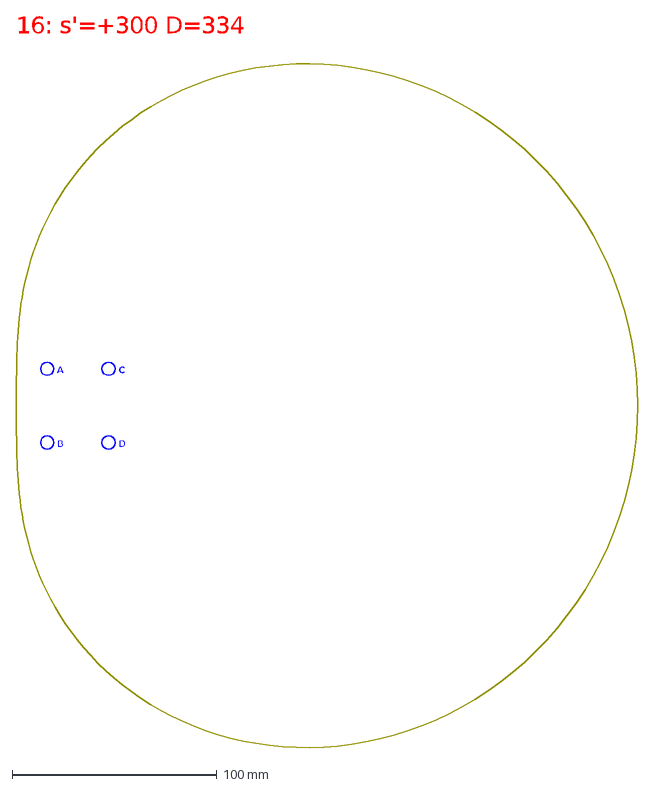
[picture p42: CAD file, 2026-04-20]
soundbox/mold/individual_slabs/slab_16.dxf
16: s'=+300 D=334
A
B
C
D
