jclements3/Erand/soundbox/mold/individual_slabs/slab_15.dxf

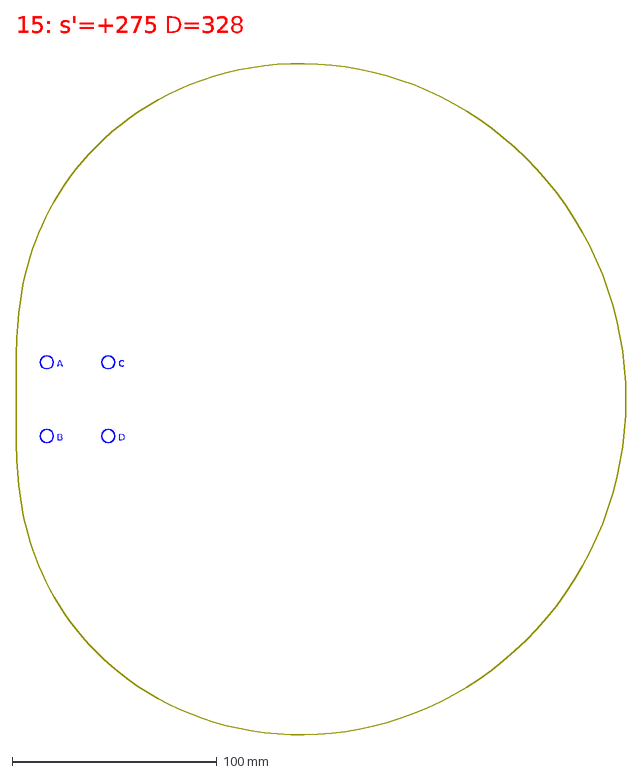
[picture p43: CAD file, 2026-04-20]
soundbox/mold/individual_slabs/slab_15.dxf
15: s'=+275 D=328
A
B
C
D
