jclements3/Erand/soundbox/mold/individual_slabs/slab_24.dxf

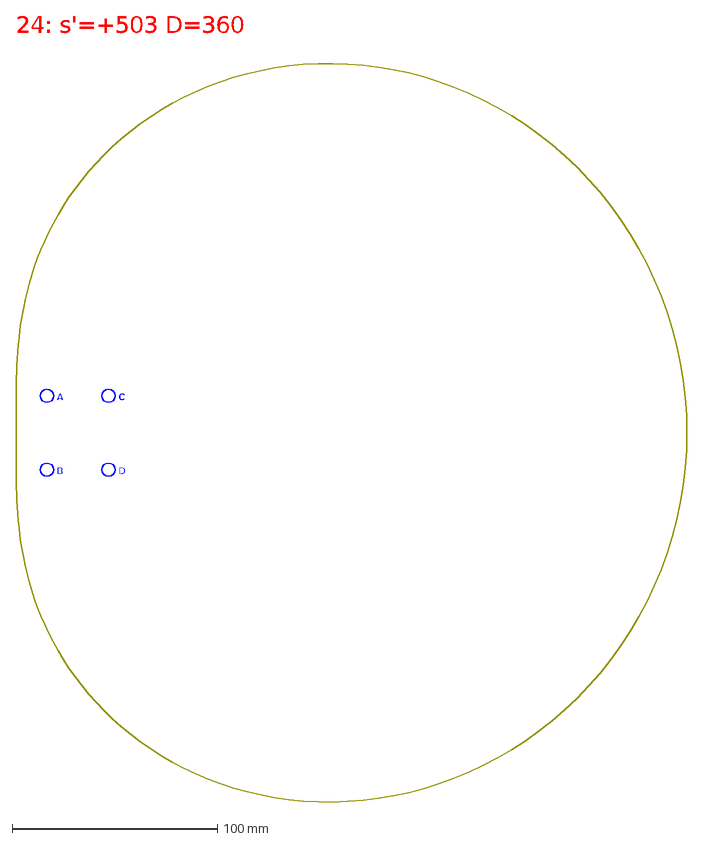
[picture p44: CAD file, 2026-04-20]
soundbox/mold/individual_slabs/slab_24.dxf
24: s'=+503 D=360
A
B
C
D
