jclements3/Erand/soundbox/mold/individual_slabs/slab_45.dxf

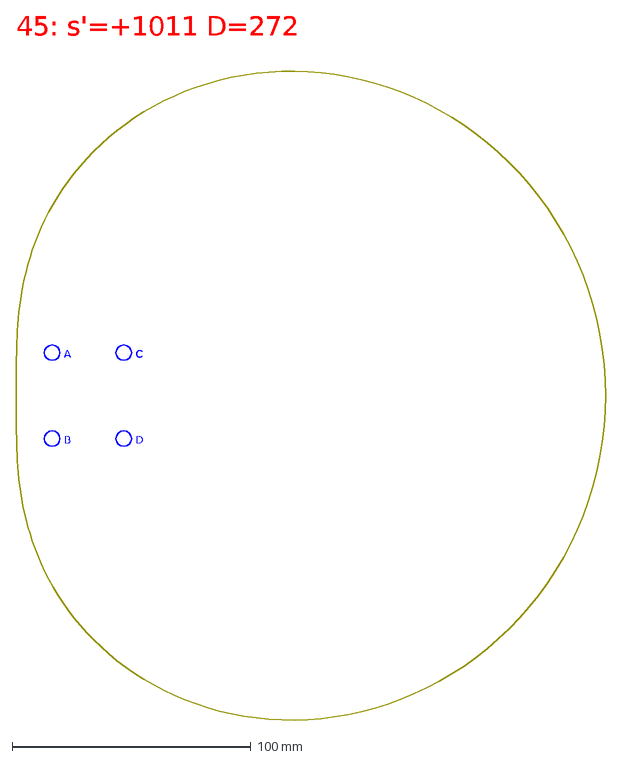
[picture p45: CAD file, 2026-04-20]
soundbox/mold/individual_slabs/slab_45.dxf
45: s'=+1011 D=272
A
B
C
D
