jclements3/Erand/soundbox/mold/individual_slabs/slab_14.dxf

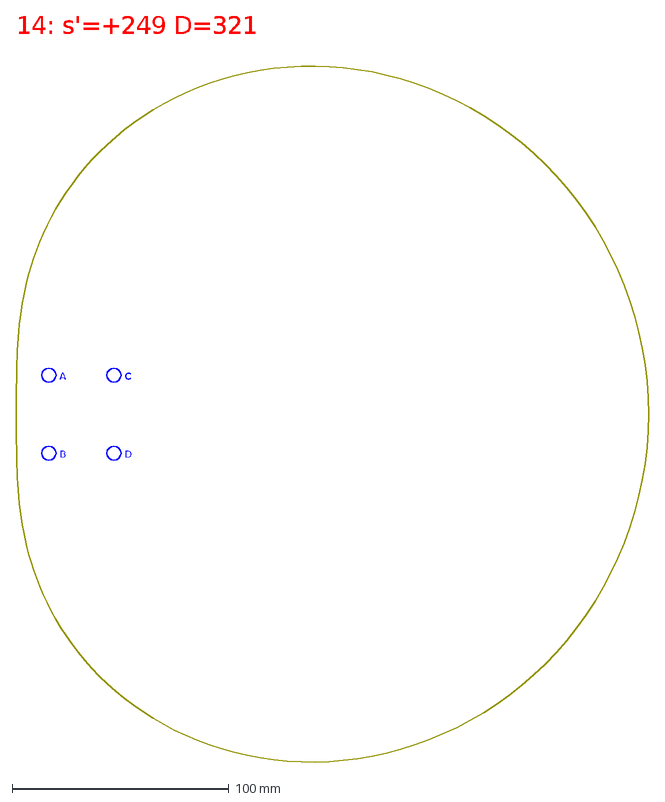
[picture p46: CAD file, 2026-04-20]
soundbox/mold/individual_slabs/slab_14.dxf
14: s'=+249 D=321
A
B
C
D
