jclements3/Erand/soundbox/mold/individual_slabs/slab_11.dxf

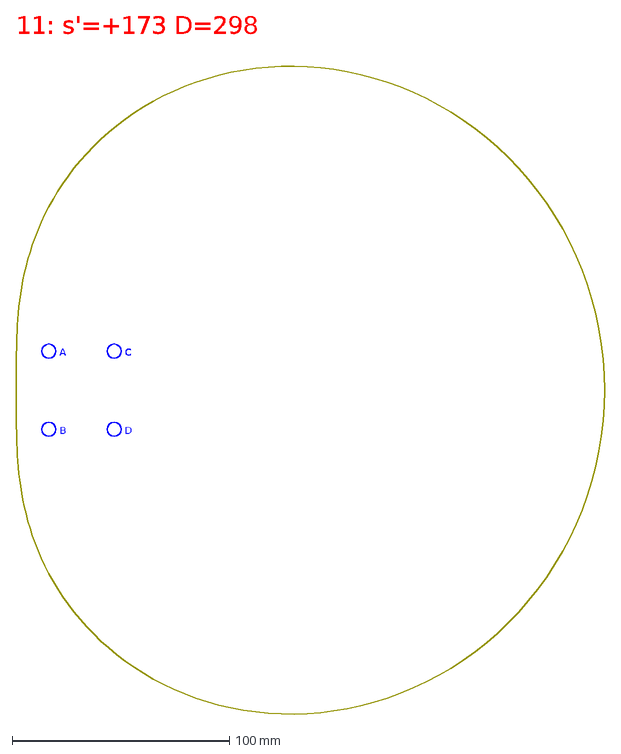
[picture p47: CAD file, 2026-04-20]
soundbox/mold/individual_slabs/slab_11.dxf
11: s'=+173 D=298
A
B
C
D
