jclements3/Erand/soundbox/mold/individual_slabs/slab_38.dxf

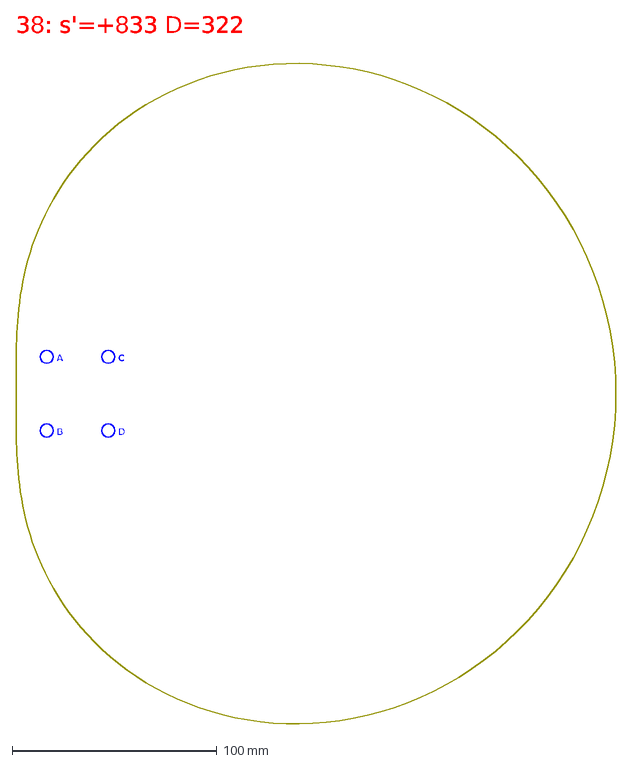
[picture p48: CAD file, 2026-04-20]
soundbox/mold/individual_slabs/slab_38.dxf
38: s'=+833 D=322
A
B
C
D
