jclements3/Erand/soundbox/mold/individual_slabs/slab_53.dxf

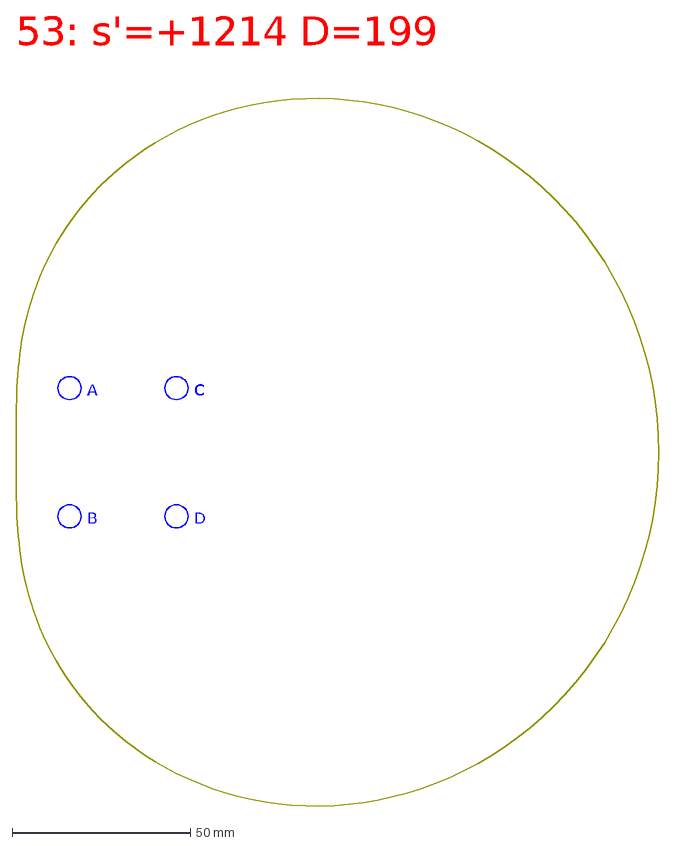
[picture p49: CAD file, 2026-04-20]
soundbox/mold/individual_slabs/slab_53.dxf
53: s'=+1214 D=199
A
B
C
D
