jclements3/Erand/soundbox/mold/individual_slabs/slab_18.dxf

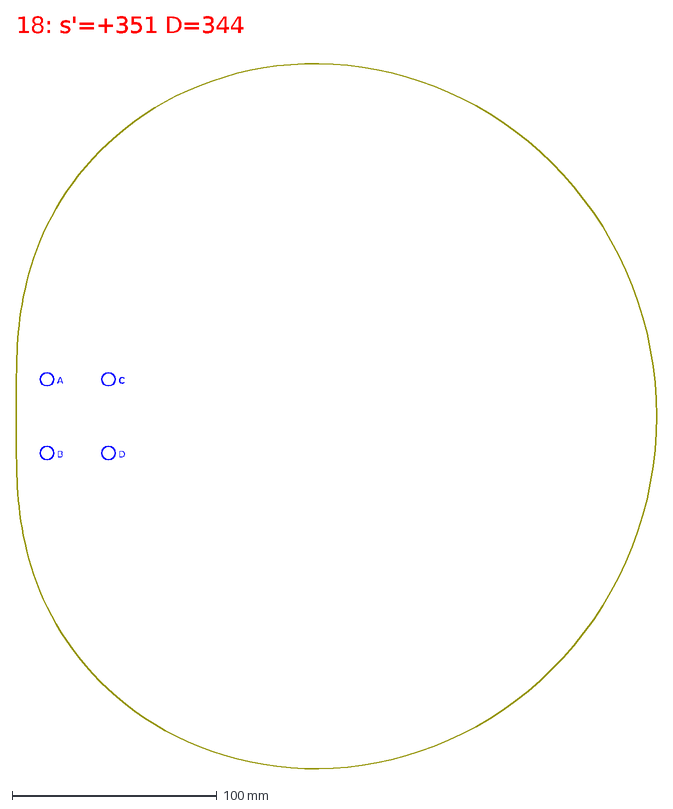
[picture p50: CAD file, 2026-04-20]
soundbox/mold/individual_slabs/slab_18.dxf
18: s'=+351 D=344
A
B
C
D
