jclements3/Erand/soundbox/mold/individual_slabs/slab_08.dxf

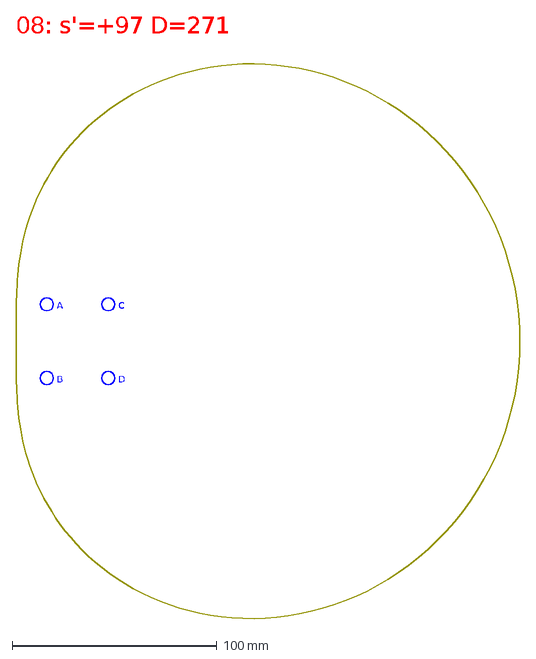
[picture p51: CAD file, 2026-04-20]
soundbox/mold/individual_slabs/slab_08.dxf
08: s'=+97 D=271
A
B
C
D
