jclements3/Erand/soundbox/mold/individual_slabs/slab_51.dxf

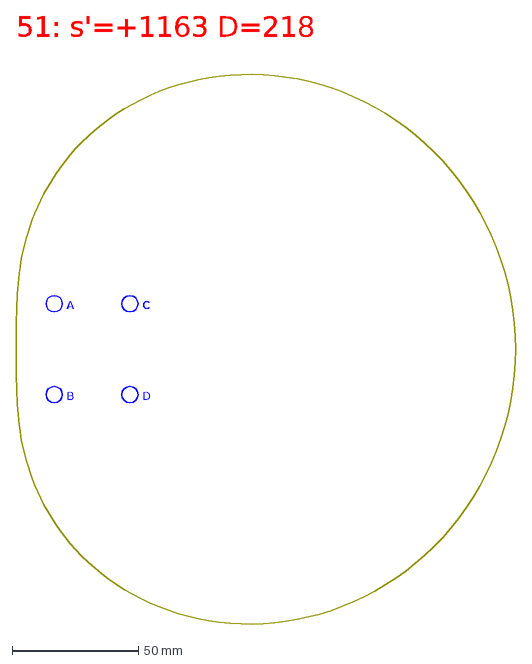
[picture p52: CAD file, 2026-04-20]
soundbox/mold/individual_slabs/slab_51.dxf
51: s'=+1163 D=218
A
B
C
D
