jclements3/Erand/soundbox/mold/individual_slabs/slab_52.dxf

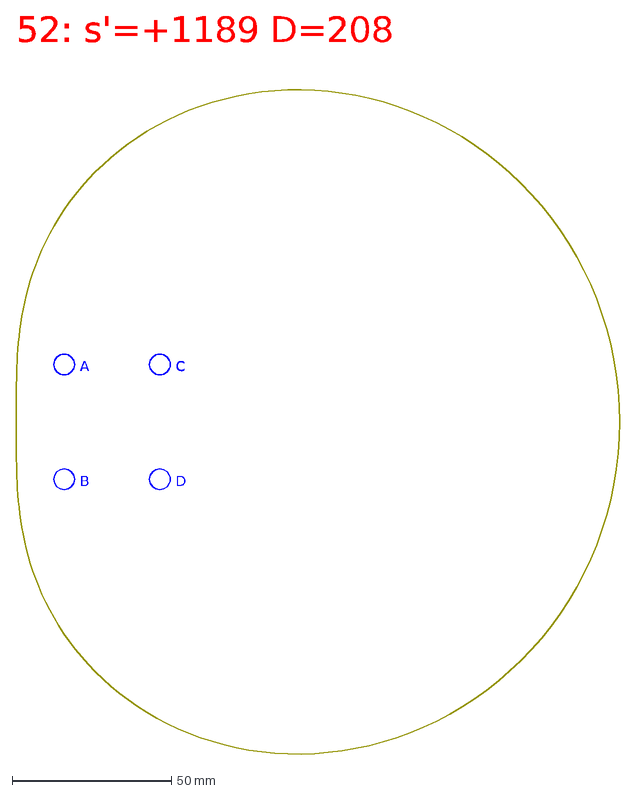
[picture p53: CAD file, 2026-04-20]
soundbox/mold/individual_slabs/slab_52.dxf
52: s'=+1189 D=208
A
B
C
D
