jclements3/Erand/soundbox/mold/individual_slabs/slab_46.dxf

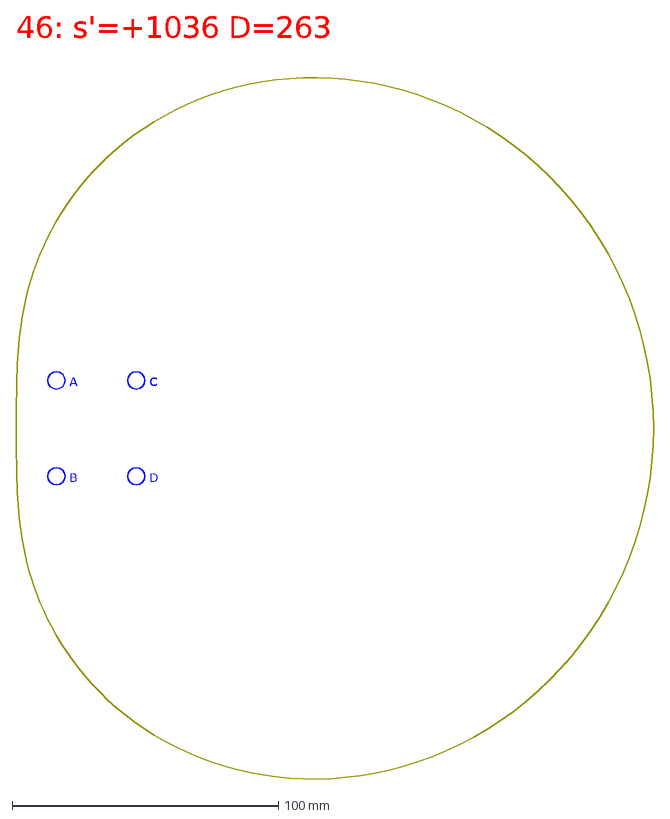
[picture p54: CAD file, 2026-04-20]
soundbox/mold/individual_slabs/slab_46.dxf
46: s'=+1036 D=263
A
B
C
D
