jclements3/Erand/soundbox/mold/individual_slabs/slab_60.dxf

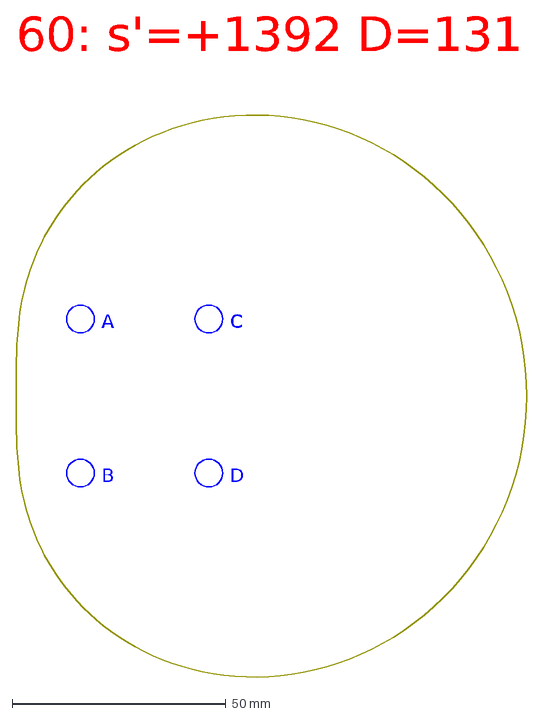
[picture p55: CAD file, 2026-04-20]
soundbox/mold/individual_slabs/slab_60.dxf
60: s'=+1392 D=131
A
B
C
D
