jclements3/Erand/soundbox/mold/individual_slabs/slab_02.dxf

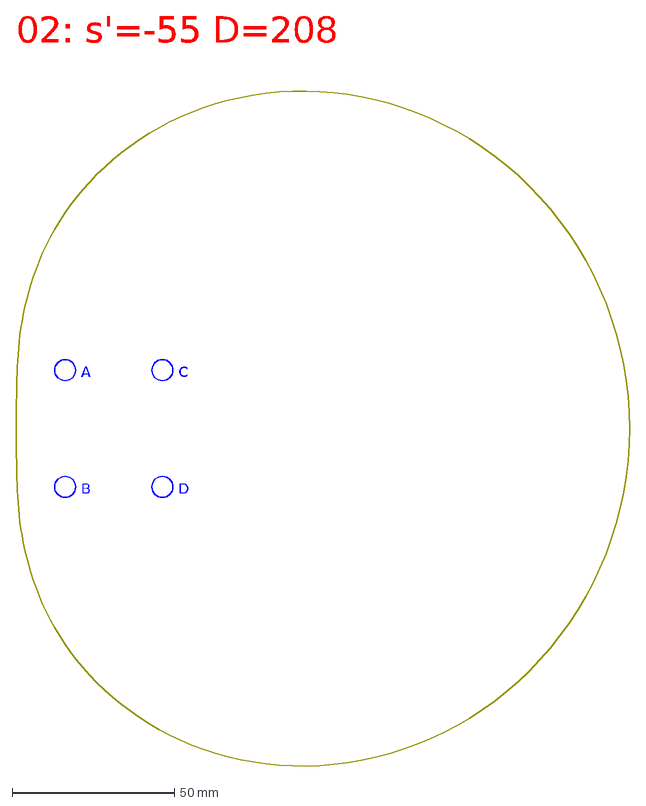
[picture p56: CAD file, 2026-04-20]
soundbox/mold/individual_slabs/slab_02.dxf
02: s'=-55 D=208
A
B
C
D
