jclements3/Erand/soundbox/mold/individual_slabs/slab_65.dxf

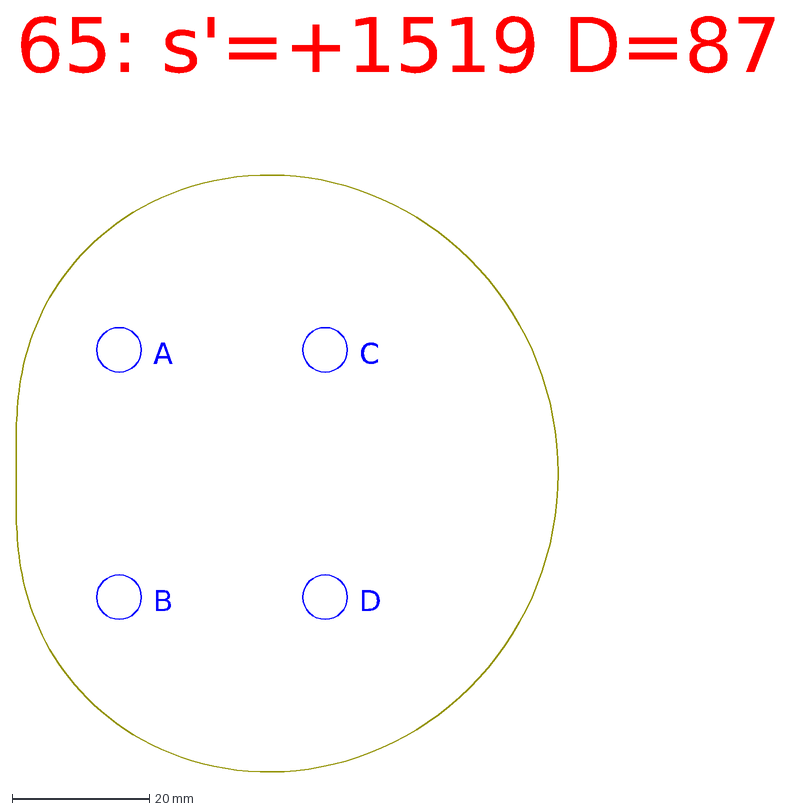
[picture p57: CAD file, 2026-04-20]
soundbox/mold/individual_slabs/slab_65.dxf
65: s'=+1519 D=87
A
B
C
D
