jclements3/Erand/soundbox/mold/individual_slabs/slab_31.dxf

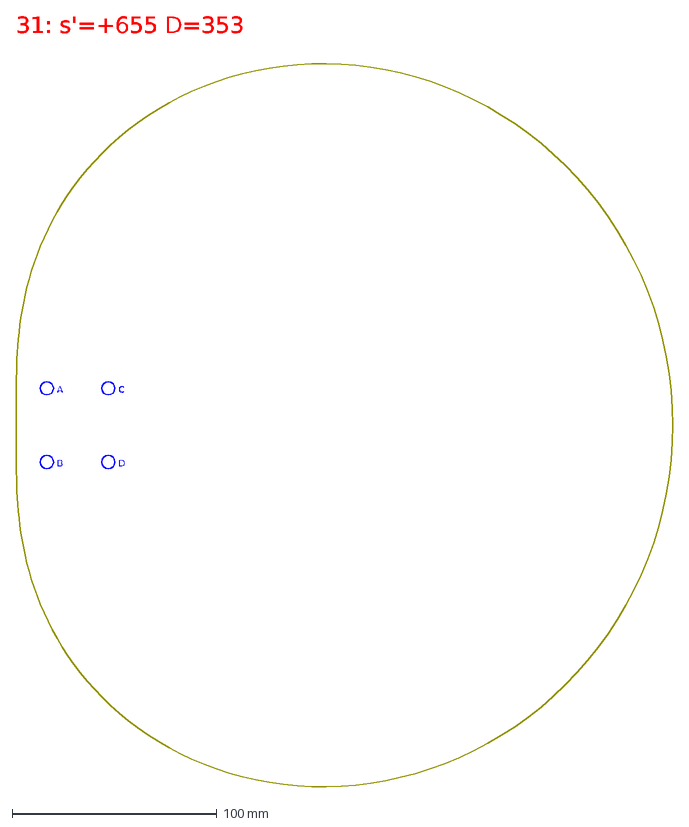
[picture p58: CAD file, 2026-04-20]
soundbox/mold/individual_slabs/slab_31.dxf
31: s'=+655 D=353
A
B
C
D
