jclements3/Erand/soundbox/mold/individual_slabs/slab_35.dxf

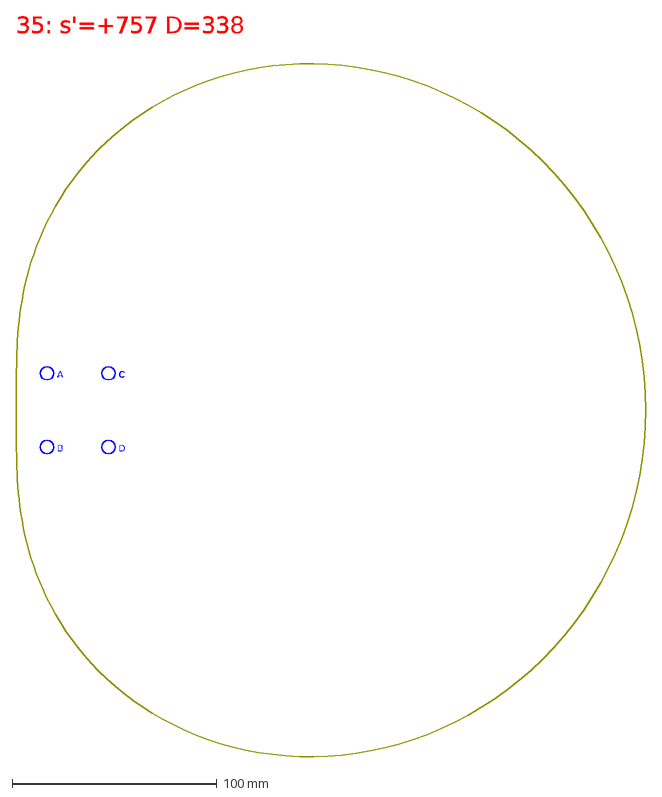
[picture p59: CAD file, 2026-04-20]
soundbox/mold/individual_slabs/slab_35.dxf
35: s'=+757 D=338
A
B
C
D
