jclements3/Erand/soundbox/mold/individual_slabs/slab_55.dxf

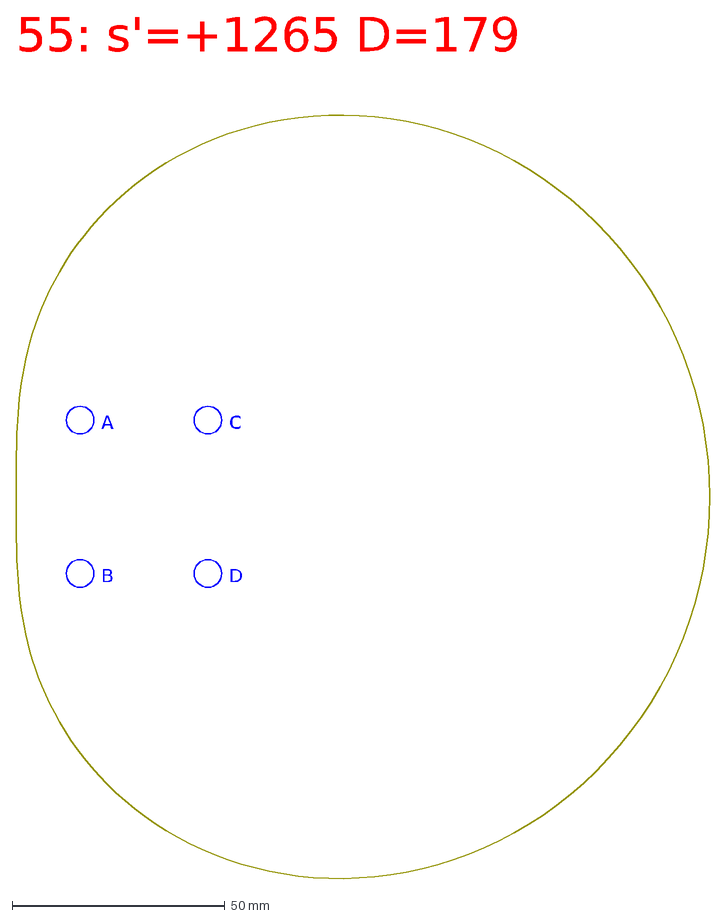
[picture p60: CAD file, 2026-04-20]
soundbox/mold/individual_slabs/slab_55.dxf
55: s'=+1265 D=179
A
B
C
D
