jclements3/Erand/soundbox/mold/individual_slabs/slab_62.dxf

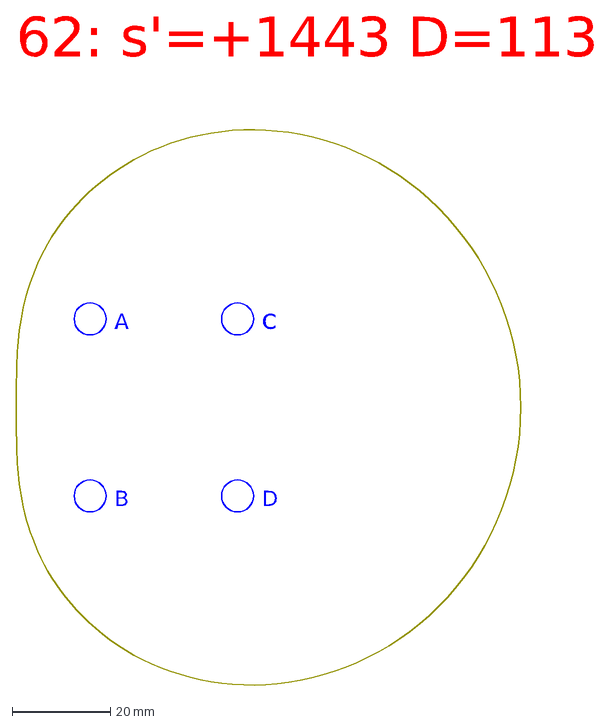
[picture p61: CAD file, 2026-04-20]
soundbox/mold/individual_slabs/slab_62.dxf
62: s'=+1443 D=113
A
B
C
D
