jclements3/Erand/soundbox/mold/individual_slabs/slab_40.dxf

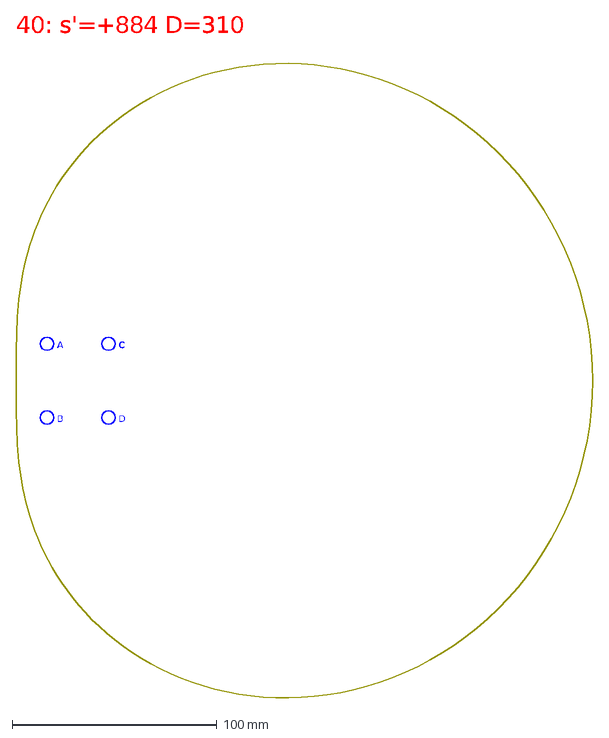
[picture p62: CAD file, 2026-04-20]
soundbox/mold/individual_slabs/slab_40.dxf
40: s'=+884 D=310
A
B
C
D
