jclements3/Erand/soundbox/mold/individual_slabs/slab_09.dxf

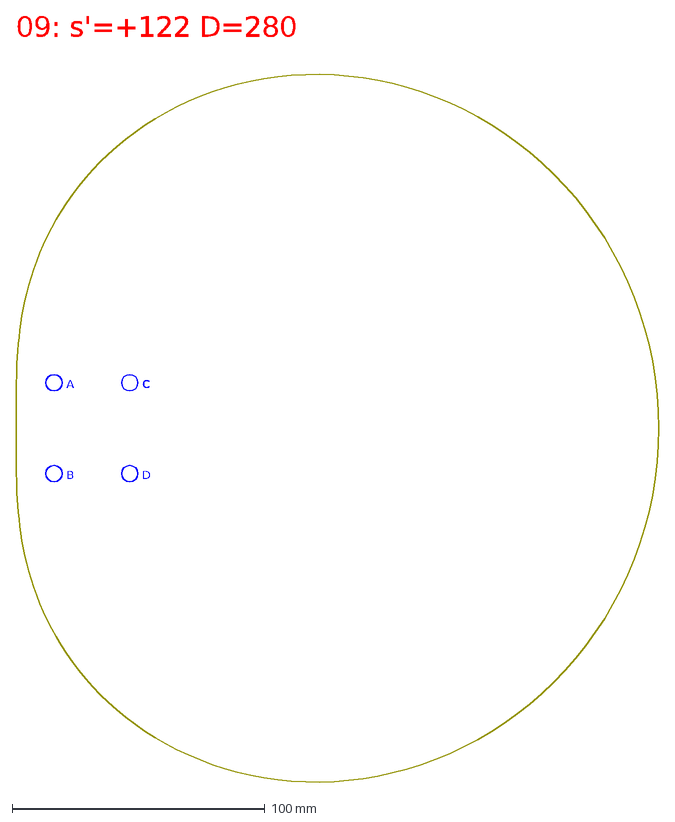
[picture p63: CAD file, 2026-04-20]
soundbox/mold/individual_slabs/slab_09.dxf
09: s'=+122 D=280
A
B
C
D
