jclements3/Erand/soundbox/mold/individual_slabs/slab_58.dxf

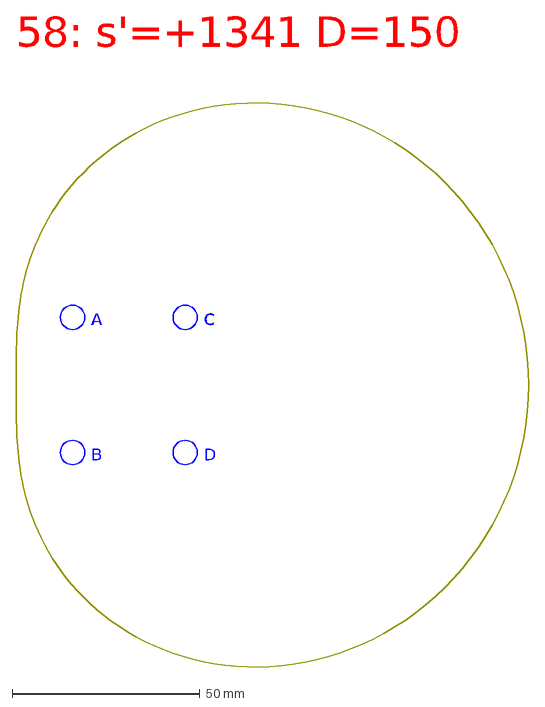
[picture p64: CAD file, 2026-04-20]
soundbox/mold/individual_slabs/slab_58.dxf
58: s'=+1341 D=150
A
B
C
D
