jclements3/Erand/soundbox/mold/individual_slabs/slab_36.dxf

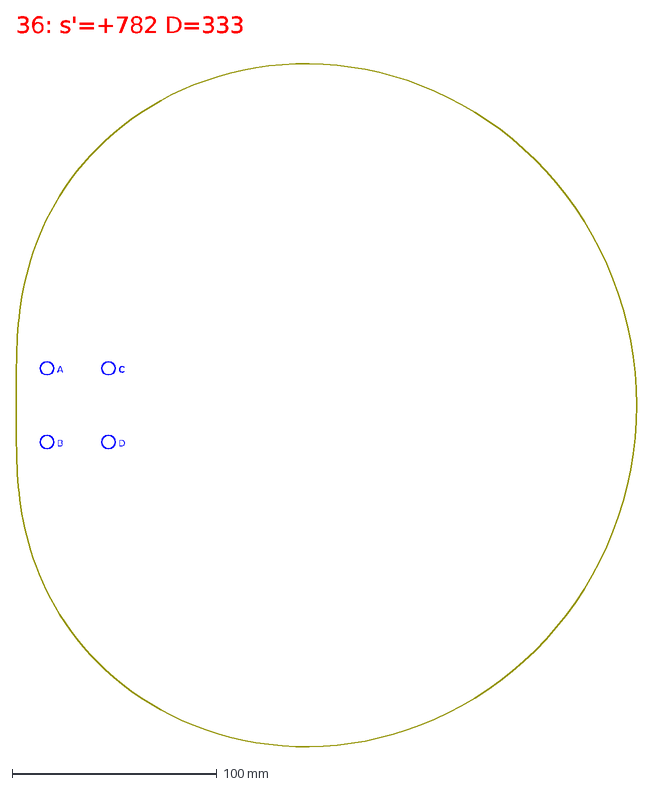
[picture p65: CAD file, 2026-04-20]
soundbox/mold/individual_slabs/slab_36.dxf
36: s'=+782 D=333
A
B
C
D
