jclements3/Erand/soundbox/mold/individual_slabs/slab_54.dxf

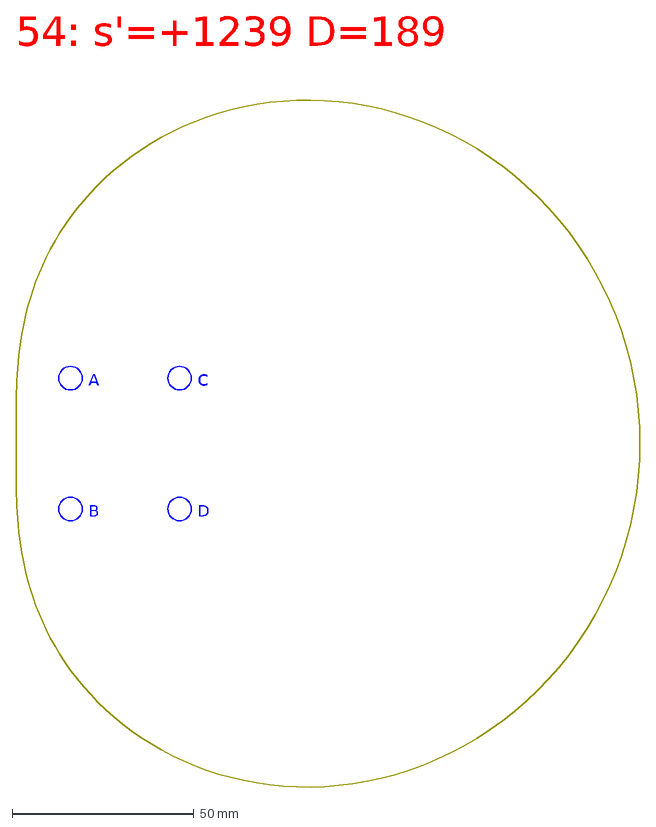
[picture p66: CAD file, 2026-04-20]
soundbox/mold/individual_slabs/slab_54.dxf
54: s'=+1239 D=189
A
B
C
D
