jclements3/Erand/soundbox/mold/individual_slabs/slab_22.dxf

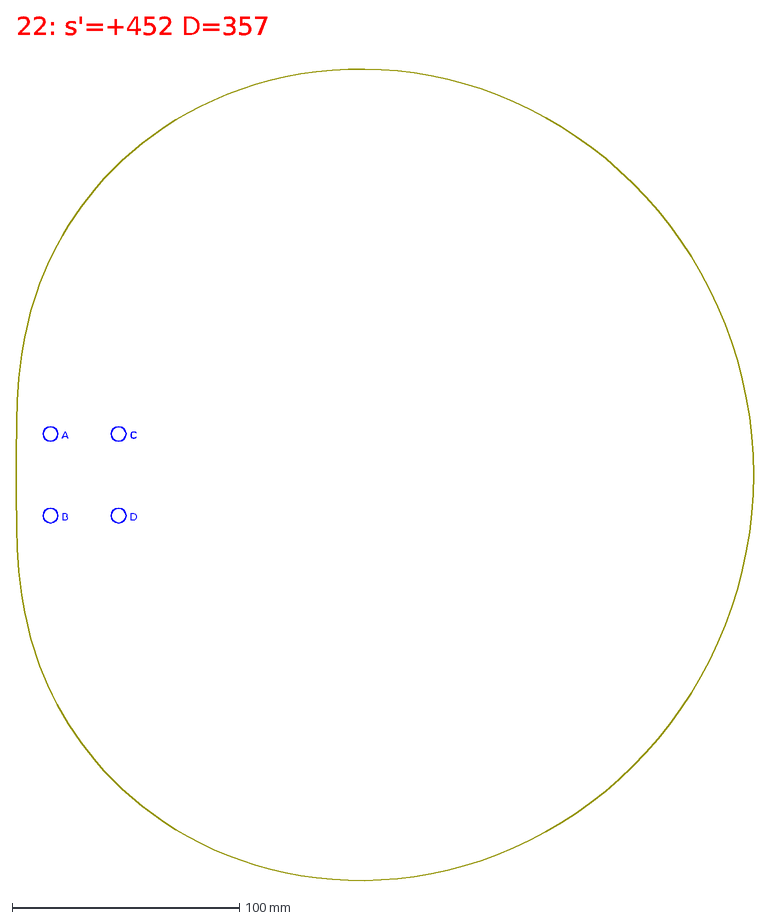
[picture p67: CAD file, 2026-04-20]
soundbox/mold/individual_slabs/slab_22.dxf
22: s'=+452 D=357
A
B
C
D
