jclements3/Erand/soundbox/mold/individual_slabs/slab_47.dxf

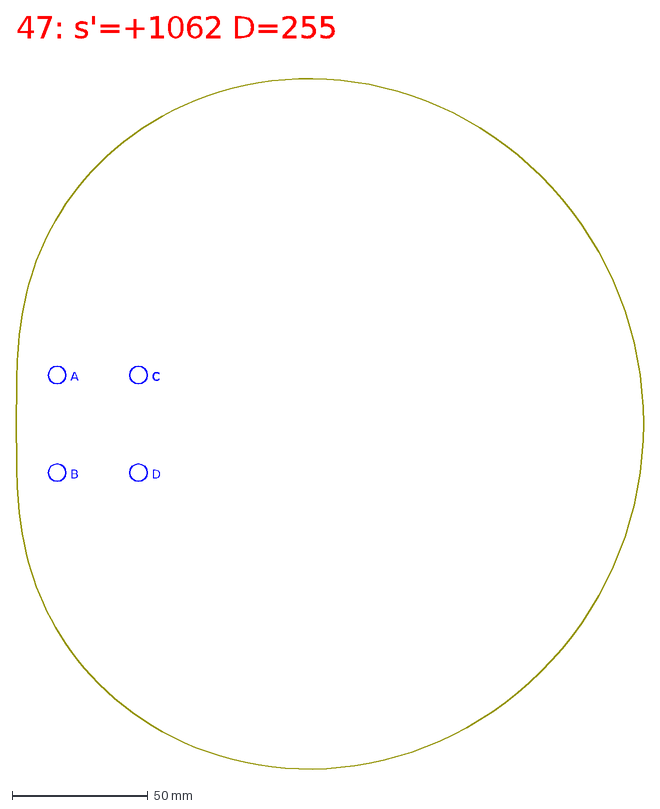
[picture p68: CAD file, 2026-04-20]
soundbox/mold/individual_slabs/slab_47.dxf
47: s'=+1062 D=255
A
B
C
D
