jclements3/Erand/soundbox/mold/individual_slabs/slab_42.dxf

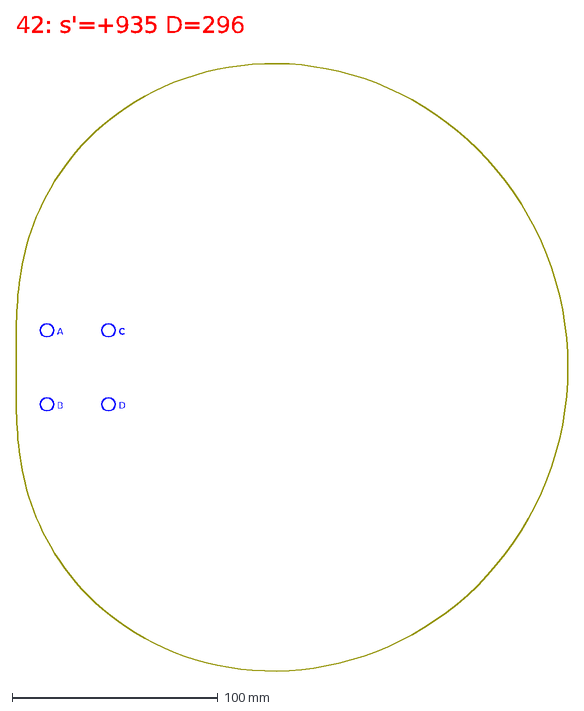
[picture p69: CAD file, 2026-04-20]
soundbox/mold/individual_slabs/slab_42.dxf
42: s'=+935 D=296
A
B
C
D
