jclements3/Erand/soundbox/mold/individual_slabs/slab_59.dxf

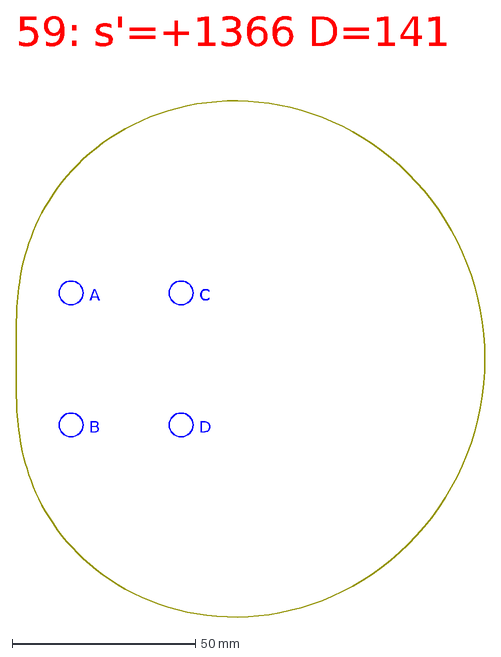
[picture p70: CAD file, 2026-04-20]
soundbox/mold/individual_slabs/slab_59.dxf
59: s'=+1366 D=141
A
B
C
D
