jclements3/Erand/(list of files, cad)

Other CAD files:
soundbox/mold/slab_templates_with_dowels.dxf
