jclements3/Erand/CURVE_FITTING_PROBLEM.md

Solve two independent instances of this problem. Do both instances; do not ask
which one to do first.

COORDINATE FRAME.
All coordinates are in SVG convention: x increases to the right, y increases
DOWNWARD. Lengths are in millimeters. Angles are in radians, measured in this
frame: angle 0 points +x, angle +pi/2 points +y (which is downward on screen).

PROBLEM.
Given a fixed cubic Bézier path f, find a tunable cubic Bézier path p of exactly
4 segments (5 nodes) that best fits f under the constraints and objective below.

HARD CONSTRAINTS.
C1. Shared endpoints: anchor 0 of p equals anchor 0 of f; anchor 4 of p equals
    the last anchor of f.

C2. C1 continuity with symmetric handles at interior anchors 1, 2, 3 of p. The
    incoming and outgoing handles are collinear with the anchor AND equal in
    length — this is full C1 continuity, not merely G1. A single width w and
    angle a per interior anchor determine both handles:
        handle_in  = anchor - w * (cos a, sin a)
        handle_out = anchor + w * (cos a, sin a)
    with w >= w_min.

C3. Endpoint anchors 0 and 4 of p each have only one real handle (outgoing for
    anchor 0, incoming for anchor 4), each parameterized by a tangent angle a
    and a half-width w >= w_min:
        handle_out_0 = anchor_0 + w_0 * (cos a_0, sin a_0)
        handle_in_4  = anchor_4 - w_4 * (cos a_4, sin a_4)

C4. Width floor: w_i >= w_min = 2.0 mm for all five anchors. This is a hard
    lower bound chosen to prevent near-cusp pathologies.

C5. Non-intersection. p and f share exactly the two endpoint anchors and have
    no other common points, INCLUDING tangent contact. Formally: the set
        { (s, t) in [0,1]^2 : p(s) = f(t) }
    equals exactly { (0, 0), (1, 1) }, where s parameterizes the full path p
    (s = 0 at anchor 0, s = 1 at anchor 4, with segment boundaries at s = k/4
    for k = 1, 2, 3) and t parameterizes the full path f analogously. Tangent
    osculation at interior points counts as an intersection and is forbidden.

    ENFORCEMENT. The constraint is enforced by the following procedure:

    (a) Arc-length exclusion near shared endpoints. Let eps_end = 1.0 mm. On
        p, exclude all parameter values s such that the arc-length distance
        from (s=0) or from (s=1) is less than eps_end. On f, apply the same
        exclusion around t=0 and t=1. Arc length is computed by Gaussian
        quadrature of |f'| or |p'| to at least 4 significant figures.

    (b) Minimum separation. Sample p at >= 128 parameter values per segment
        (= 512 total on p, since p has exactly 4 segments), and sample f at
        >= 64 parameter values per segment (>= 64 * n_segs_f total on f). For every pair consisting of
        one p-sample and one f-sample that both lie OUTSIDE the arc-length
        exclusion zones of (a), require Euclidean distance >= d_min = 0.1 mm.

    (c) Transversal intersection rejection. Solve for all intersection
        parameters (s, t) between p and f using Bezier clipping, subdivision,
        or an equivalent root-finder with tolerance <= 1e-6 in parameter
        space. Reject any candidate p for which a solution (s, t) exists
        with p(s) outside the arc-length exclusion zone on p AND f(t)
        outside the arc-length exclusion zone on f.

    A candidate p passes C5 iff (b) and (c) both hold.

TUNABLE PARAMETERS ON p — 16 total.
- Positions of anchors 1, 2, 3: 6 numbers.
- Tangent angles at all 5 anchors: 5 numbers.
- Handle half-widths at all 5 anchors: 5 numbers.
Anchor 0 and anchor 4 positions are fixed by C1.

OBJECTIVE.
Let L be the closed loop formed by f traversed forward (anchor 0 to its last
anchor) followed by p traversed in reverse. The signed area of L is

    A_signed = - closed_integral_L y dx = + closed_integral_L x dy

(these two are equal on a closed curve, and each equals (1/2) * closed
integral of (x dy - y dx)). For a single cubic Bezier segment with control
points P0, P1, P2, P3 (where each Pk = (x_k, y_k)), the contribution to
integral_0^1 y(t) x'(t) dt is, in closed form:

    J_seg = (1/20) * [
          x_0 * (  -10*y_0 -  6*y_1 -  3*y_2 -   y_3 )
        + x_1 * (   6*y_0 -  3*y_2 -  3*y_3          )
        + x_2 * (   3*y_0 +  3*y_1 -  6*y_3          )
        + x_3 * (    y_0 +  3*y_1 +  6*y_2 + 10*y_3 )
    ]

Summing J_seg over all cubic segments of L in traversal order gives
sum_L J_seg = integral_L y dx = -A_signed. The segments of L are: the
segments of f in forward order, followed by the segments of p in REVERSE
order (each p-segment also reversed internally: P0 <-> P3 and P1 <-> P2).

SANITY CHECK. For a single cubic from (0,0) to (1,1) with controls
P0=(0,0), P1=(1/3,1/3), P2=(2/3,2/3), P3=(1,1) lying on y=x, J_seg = +0.5,
matching integral_0^1 y x' dt = integral_0^1 t * 1 dt = 1/2.

The objective value is

    A = | A_signed | = | sum_L J_seg |

and the problem is to minimize A. The sign of A_signed is not constrained;
p may lie on either side of f, and the optimizer is free to choose whichever
side yields the smaller enclosed area. Because C4 and C5 prevent collapse and
contact, A is strictly positive at any feasible point and a positive minimum
exists.

NOTATION — f (Cartesian, asymmetric handles allowed).
Each anchor line has: index, position (x, y), incoming handle absolute
position (ix, iy), outgoing handle absolute position (ox, oy). Handles are
absolute coordinates, not offsets. The first anchor has no incoming handle
(dashes); the last anchor has no outgoing handle (dashes).

NOTATION — p (symmetric, polar handle parameterization).
Each of 5 anchors (indices 0–4) has position (x, y), tangent angle a in
radians, and handle half-width w >= w_min. Handles are constructed per C2
and C3.

INSTANCE 1 — f has 38 anchors. Format per line: i x y ix iy ox oy.
0  811.445 418.868  -       -        809.106 422.612
1  800.607 426.481  804.217 423.939  795.711 429.928
2  786.859 438.041  791.439 434.185  769.084 453.004
3  733.559 482.958  751.295 467.949  733.166 483.290
4  734.796 482.037  735.227 481.756  725.910 487.830
5  708.151 499.437  717.027 493.627  707.642 499.770
6  709.749 498.551  710.302 498.297  691.962 506.734
7  656.448 523.245  674.174 514.931  655.712 523.591
8  658.751 522.437  659.541 522.245  645.072 525.771
9  617.729 532.497  631.399 529.129  617.056 532.662
10 619.782 532.170  620.473 532.118  605.429 533.239
11 576.727 535.421  591.076 534.308  575.751 535.497
12 579.663 535.542  580.629 535.703  574.881 534.749
13 565.301 533.255  570.097 533.959  564.000 533.064
14 569.054 534.476  570.219 535.086  559.540 529.495
15 540.361 519.825  549.931 524.697  539.847 519.563
16 541.845 520.717  542.317 521.049  531.611 513.537
17 511.120 499.210  521.380 506.353  510.475 498.761
18 512.916 500.737  513.463 501.302  507.807 495.466
19 497.547 484.963  502.677 490.214  497.148 484.554
20 498.657 486.268  498.995 486.728  493.534 479.319
21 483.264 465.439  488.399 472.379  483.011 465.098
22 483.968 466.500  484.185 466.866  466.216 436.534
23 452.539 418.689  472.058 444.905  451.848 417.761
24 454.194 421.741  454.598 422.826  435.690 371.995
25 421.996 345.357  443.433 390.285  421.831 345.012
26 422.442 346.413  422.574 346.772  416.909 331.423
27 405.820 301.453  412.037 316.172  402.845 294.408
28 371.821 228.941  374.428 234.590  366.014 216.357
29 354.396 191.193  360.202 203.777  342.778 166.015
30 319.548 115.656  331.196 140.820  318.856 114.162
31 316.668 111.690  317.876 112.809  315.457 110.568
32 312.494 109.123  314.037 109.705  279.218  96.578
33 238.613  92.079  291.092 101.627  190.563  83.336
34 146.284  89.181  181.476  82.402  140.306  90.333
35 128.351  92.637  134.329  91.485  127.924  92.719
36 107.030  97.263  112.500  94.414   75.566 113.656
37  12.700 146.563   12.700 111.084   -       -

INSTANCE 2 — f has 15 anchors. Same format.
0   12.700 323.844   -      -        43.063 323.986
1  103.790 324.269   73.634 327.810  139.980 320.020
2  210.517 300.617  174.170 298.034  245.962 303.137
3  310.000 338.928  278.243 322.982  316.966 342.426
4  324.045 357.625  320.288 350.795  357.881 419.139
5  422.653 543.733  384.485 484.809  439.752 570.131
6  488.423 611.392  462.664 593.343  507.108 624.486
7  552.718 634.875  530.334 630.453  568.048 637.903
8  599.573 633.349  584.324 636.764  615.835 629.708
9  645.694 614.056  630.966 621.852  673.798 599.179
10 727.793 565.475  702.585 584.857  761.377 539.653
11 821.100 479.188  790.525 508.511  822.884 477.478
12 814.417 482.399  816.719 481.498  813.833 482.628
13 812.541 482.539  811.914 482.551  821.289 482.374
14 838.784 481.939  830.036 482.139   -      -

NOTE ON SOLVER DEPENDENCE. This problem is nonconvex. Different optimization
strategies (initialization, local search method, multistart seed count) will
find different local minima. Reported A values are implementation-dependent;
lower values are better. A solver that reports A without making a credible
attempt at optimization is not answering the problem. Reproducibility across
implementations is not expected.

OUTPUT for each instance.
1. The 16 parameters of p as a labeled list:
     anchor 1: x, y
     anchor 2: x, y
     anchor 3: x, y
     angles  a_0, a_1, a_2, a_3, a_4   (radians)
     widths  w_0, w_1, w_2, w_3, w_4   (mm)
2. The final value of A = | A_signed |, computed via the exact closed-form
   J_seg sum above, reported to at least 6 significant figures, in mm^2.
3. A self-contained SVG artifact with ALL of the following:
     - Root element <svg> with explicit viewBox set to the axis-aligned
       bounding box of the union of all f control points (anchor positions
       and handle positions), expanded by 20 mm on every side. The width
       and height attributes equal the viewBox width/height in mm.
     - f rendered as a solid stroke, color #1f77b4, stroke-width 1.0,
       fill="none".
     - p rendered as a solid stroke, color #d62728, stroke-width 1.0,
       fill="none".
     - The enclosed region L filled with fill="#d62728" fill-opacity="0.25"
       stroke="none".
     - The 5 anchor positions of p marked as filled circles, r=3,
       fill="#d62728".
     - A <text> caption inside the SVG, placed at the top-left of the
       viewBox with a 5 mm inset, font-size="3", reading exactly:
           "A = <value> mm^2"
       where <value> is the number from output item 2.
     - No external references, no CSS classes, no scripts. All attributes
       inline. The file must render identically in any standards-compliant
       SVG renderer.
   Name the file  instance1.svg  or  instance2.svg  accordingly.

Label the two instances clearly in the response. Do not ask clarifying
questions — the specification above is complete.

---

# SOLUTION ATTEMPT

Solver: `solve_curve_fit.py`. Results:

| Instance | A (mm²) | min signed dist (mm) | feasible? |
|---|---|---|---|
| 1 | 15039.09 | 0.240 | yes |
| 2 | 4445.27 | 0.483 | yes |

Output files: `instance1.svg`, `instance2.svg`, `curve_fit_results.json`.

## WHAT WORKS

**C1-parametrized p.** The 16-parameter form (3 interior (x,y), 5 angles, 5
half-widths) fits cleanly into `scipy.optimize.minimize` with L-BFGS-B. Only
the widths need box bounds; the angles are unconstrained and their values
drift by 2π freely (the trig reduction handles periodicity).

**Closed-form J_seg for the objective.** Computing |A_signed| via the
coefficient table is exact and fast. No sampling-density dependence in the
objective itself.

**Warm-start by offsetting f perpendicularly at quartile arc-length points.**
Picks 3 interior anchors that roughly track f's shape. Tangent angles taken
from f's tangent at those points. Widths set to ~arclen/12. Gets within an
order of magnitude of the final A before any optimization.

**Signed-distance one-sidedness penalty.** For each non-endpoint p-sample,
find the nearest f-sample, project the offset onto f's normal direction, and
require `desired_sign * signed_distance >= d_target`. This simultaneously
enforces: (a) p on the designated side of f, (b) no p-f crossing, (c)
separation ≥ `d_target`.

**Safety-margin schedule `d_target` > D_MIN during optimization.** Running
opt with `d_target = 0.5, 0.3, 0.2` mm (tightening with each penalty stage)
while validating at the spec's `D_MIN = 0.1 mm` creates enough buffer for
the optimizer to stabilize before the final feasibility check. Without this,
coarse-sampling opt routinely lands at min_sd ≈ 0.04–0.09 mm — feasible
under coarse sampling but infeasible when validated at full density.

**Multistart on offset sign and magnitude.** 2 × 2 = 4 starts ({+1, -1} ×
{15mm, 40mm}). Sufficient to find feasible solutions on at least one side.

## WHAT DOES NOT WORK

**Symmetric Euclidean-distance penalty (first attempt).** `pen = Σ
max(0, D_MIN − dist)²` over all p-sample × f-sample pairs drives `|A_signed|`
to zero, not to the true minimum area. Reason: with coarse sampling, p can
"slip through" f between samples. Each sample stays 0.1 mm away, but the
curve itself crosses. The resulting loop has opposite winding in adjacent
regions, so signed areas cancel to ~0 while "paint" area stays large. The
spec's A = |A_signed| is exploitable this way: **this is a real hole in the
objective**. Any p that self-intersects or crosses f produces a figure-
eight-type loop with cancelling signed area.

**Plain non-adjacent-segment self-intersection check.** Looking only at
pairs of p-samples on segments |i − j| ≥ 2 misses crossings inside a
single segment and crossings between adjacent segments sharing an anchor
but with long opposing handles. An arc-length-separation check (samples
with arc-length gap ≥ some threshold) is better.

**Low initial penalty weight.** Penalty continuation starting at `pw = 1`
gave the optimizer free rein to collapse p into f. The penalty gradient
was too weak to push p back out. Starting at `pw = 1e4` or higher from
the first iteration prevented this.

**Final full-sampling refine with L-BFGS-B and high penalty.** Attempted a
validation-density refine (128 samples/p-seg, 64 samples/f-seg, pw=1e7).
Even at `maxiter=40` this often stalls for 60+ seconds per multistart and
yields negligible improvement when the coarse-stage result is already
feasible. Skipping it and just validating at full sampling is strictly
faster and gave the same answers.

**Constraint-method solvers (trust-constr with NonlinearConstraint).**
Tried briefly — the gradient from the pairwise-distance penalty is noisy
enough that the trust-region updates waste iterations. L-BFGS-B with a
smooth quadratic penalty (not log-barrier) was more stable.

## LIMITATIONS / RESIDUAL ISSUES

**Not a global minimum.** For Instance 1, the s=+1 m=15 multistart reached
A = 13079 but landed 0.043 mm past the constraint boundary (infeasible).
The reported feasible A = 15039 is ~15% higher. A finer multistart or a
reformulation with the constraint as hard equality would likely squeeze
this down into the 13–14k range.

**Bezier self-intersection is not rigorously ruled out.** The
arc-length-separated sample check catches gross self-crossings but is not a
true intersection root-finder. Bezier clipping (C5(c) in the spec) was not
implemented — samples + arc-length separation were sufficient empirically
but are not a proof of non-intersection.

**|A_signed| spec hole (unfixed).** The |A_signed| objective can be gamed
by any p that self-intersects or crosses f to produce cancelling windings.
The solver avoids this via the one-sidedness penalty, but the spec itself
does not forbid the exploit. A tighter spec would require either
(a) disallowing p self-intersection explicitly, or (b) using an unsigned
polygon-triangulation area instead of |A_signed|.

**Validation-sampling gap.** Coarse sampling during opt misses some
close-approach regions that full sampling detects. The `d_target` margin
schedule papers over this, but a principled fix (adaptive sampling that
refines where p-f distance is small) would be cleaner.
