jclements3/Erand/(commit log)

2026-04-19 Initial commit: Erand harp analysis and SVG generator
    Scripts, DXF/JPEG source assets, and intermediate analysis files for
    deriving the Erard concert harp's geometry (column, neck, soundboard,
    47 strings + pins/flats/naturals/sharps) from the Paris 1901 reference
    drawing. make_svg.py renders erand.svg with a C²-continuous neck curve
    optimized for 24 mm pin clearance while preserving H1/H2 handle
    constraints (vertical at NKT, along soundboard at SBT).
    [erand.dxf, points.csv]
2026-04-19 Neck outline experiments: tangent-arc envelope with circle skipping
    Intermediate state; the convex-hull-of-circles tangent/arc envelope skips
    too many circles in the sharp-buffer U-dip region, so the path takes long
    straight tangent shortcuts across the dips instead of wrapping tightly.
    Lower-envelope of sharp buffers uses 16/45 circles; upper-envelope of
    pin buffers uses a handful. Corners (NB, SB, ST, NT) preserved.
    Known issue: straight tangent segments between non-adjacent envelope
    circles skip over the U-shape dips rather than tracing them.
2026-04-19 Tight neck outline: include every buffer circle
    Previous convex-hull approach took straight shortcuts across the U-dip.
    Now the tangent-arc envelope uses every sharp-buffer circle (45) and
    every pin-buffer circle (47) on the neck perimeter: tangent segments
    between consecutive circles plus short arcs on each, giving a tight
    wrap around the entire buffer ring chain. The circles are closely
    spaced (~15 mm between centers vs 12 mm radius) so very few circles
    can be safely skipped — attempting to skip produces a tangent that
    enters the skipped circle.
2026-04-20 Erand47 harp + neck Bezier iterations
    New pipeline (post-handoff):
    - build_harp.py: data-driven generator of erand47.svg from a single config.
    - bezierfit.py: Philip Schneider's cubic-Bezier fit (GraphicsGems).
    - neck_geodesic.py: feasible scalloped polyline (tangent lines + arcs).
    - leg2_bezier.py: fits both legs as Bezier chains through the geodesic
    polyline; leg 2 includes a hand-constructed ST->G7fb11 first segment
    (locked soundboard-slope tangents, L_st = 2*L_g7).
    - sweep.py: Schneider tolerance sweep (speed dial); produces
    erand47_{slow,medslow,medium,medfast,fast,fastest}_e*.svg.
    - decimate.py: greedy anchor-removal decimation of leg 1, producing
    erand47_dec_n{30,20,15}.svg.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
    [decimate_metrics.csv, sweep_metrics.csv]
2026-04-20 Integrate soundbox handoff
    Merges ~/Downloads/soundbox_handoff.tar.gz into soundbox/. Adds the
    authoritative soundbox geometry (geometry.py), limaçon taper, slab
    mold (68 DXF templates), grommets CSV, and construction/interface docs.
    Naming alignment with the soundbox module:
    - The pre-handoff CO at (51.700, 1741.510) has been renamed to CI
    (column inner × soundboard), per soundbox/geometry.py.
    - A new CO at (12.700, 1803.910) is introduced (column outer × extended
    soundboard slope on the floor plane).
    - Soundboard line in the SVG now rendered CI -> ST (the actual
    soundboard), not CO -> ST.
    - Unit vector SOUNDBOARD_DIR unchanged: CO and CI lie on the same slope.
    - FLOOR_Y = 1915.5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
    [grommets.csv, slab_00.dxf, slab_01.dxf, slab_02.dxf, slab_03.dxf, slab_04.dxf, slab_05.dxf, slab_06.dxf]
2026-04-20 Add NECK_STATUS.md handoff notes
    Summarises for the next Claude session:
    - Canonical state of erand47.svg (full Bezier neck, feasible).
    - Alternative erand47_dec_n20.svg (smoother, 0.5 mm cosmetic penetration).
    - Regeneration pipeline.
    - Design-locked constraints (ST exit, G7fb11 tangent, L_g7 = 40, L_st = 80,
    0.6 mm outward offset of the geodesic polyline).
    - Open thread: BT (Box Top) point, x-coordinate pending.
    - SKIPPED_BUFFERS naming convention (a2fb -> (13, "flat"), etc).
    - Soundbox naming alignment (CO/CI rename).
    - Failed attempts history (fitneck5-8), so those approaches aren't retried.
    - User feedback patterns to follow.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
2026-04-21 Re-route pink polyline for lowered ST/BT + F7sb exit
    Leg 1 now excludes G7 sharp from the obstacle chain. With ST lowered
    to y=494.265 (F7sb south pole), the horizontal tangent line from F7sb
    passes 12+ mm south of G7sb and wraps to it are unnecessary — G7sb
    sits as a free-standing buffer inside the neck material.
    BT is recomputed from soundbox bulge_tip_point via binary search
    against bh.ST[1], since soundbox/geometry.py's baked S_TREBLE_CLEAR
    is still pinned to the old ST y=481.94.
    Updated erand47.svg and erand47jc.svg.
2026-04-22 v2 neck + clicky-pen pitch mechanism + multi-view viewer
    Design decisions:
    - No foot pedals on this harp. Each string gets two clicky-pen paddles
    (one engages the flat/natural buffer, one engages the sharp buffer).
    94 clickies total; design in pedal/.
    - Canonical neck outline is now erand47jc_v2_opt.svg (10-node Bezier,
    zero buffer penetration, optimizer-tuned).
    Tooling:
    - optimize_v2.py — coordinate-descent solver with slide-on-circle
    anchors (n2, n3, n4, n7), free 2-D floater (n8), and per-node
    constraints (locked handles at n5/n6, symmetric handles at n7, etc.).
    - build_views.py + index.html — 5-view browser viewer
    (side / top / front / rear / soundboard-face) served from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
2026-04-22 Parameterize harp design + drawing/viewer cleanup pass
    Refactor (three parallel agents + manual stitching):
    - strings.py: new single-source StringSpec for per-string data (47 entries).
    - inkscape_frame.py: new module for INKSCAPE_DX/DY shared between
    build_views.py and optimize_v2.py.
    - build_harp.py: _FLAT_BUFFER_CENTERS replaced by pin + FLAT_BUFFER_OFFSET
    computation (0.025 mm max drift from hand-set table).
    - optimize_v2.py: R_BUF reads bh.R_BUFFER; circle anchors D1SB/E5S/G7SB/G7FB
    resolve by note name; Inkscape frame via shared module.
    - soundbox/geometry.py: DESIGN PARAMETERS vs DERIVED QUANTITIES split;
    GROMMETS derives from grommet_sp(i) via six-tier pitch schedule.
    Drawing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
2026-04-22 Add nat clicky buffer + guitar tuner adaptation
    Data:
    - build_harp.py: third buffer per string added. Each StringSpec now has
    flat_buffer (= guitar tuner hole), nat_buffer = _natural(pin, grom)
    (= nat clicky), sharp_buffer (= sharp clicky). 141 R=12 circles total
    (47x3). Color-coded: gray / blue / red. has_nat_buffer flag added.
    - neck_geodesic.py: feasibility assertion — all 47 nat buffers sit
    inside the pink polyline envelope. Confirmed: zero violations.
    Guitar tuner hardware:
    - pedal/reference/thingiverse-6099101-noamtsvi-guitar-tuners/: unpacked
    from Thingiverse 6099101 (noamtsvi, CC-BY-NC). STLs + PDF + images
    gitignored; attribution files + new dimensions.md committed.
    -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
2026-04-22 Alternate tuner + clicky drill holes by string parity in top view
    Convention: EVEN strings mount on +z (right) plate, ODD on -z (left).
    Avoids drilling both plates at the same x, which would split the neck
    under string tension.
    build_views.py:
    - Top view now draws three drill holes per string on the active plate:
    tuner gear post (Ø16 mm white) + nat clicky shaft (Ø6.5 blue) + sharp
    clicky shaft (Ø6.5 red), all centered on the plate midline.
    - Flipped z_sign in top/front/rear views so even=+z per user spec
    (was odd=+z). Tuner bodies follow the same alternation.
    - Side view flat pin: small circle (R=1.5) tangent to the string's east
    edge instead of a dot centered on the string —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
2026-04-22 Update HANDOFF + regenerate erandharp.txt for hole alternation pass
    HANDOFF.md: add TL;DR for commit c8de11d (parity alternation, top-view
    drill holes, tangent flat pin in side view). Prior pass TL;DR kept.
    erandharp.txt: rebuilt with current state for web-claude transport.
2026-04-22 Redraw clicky pen and tuner as product silhouettes + tuner in side view
    build_views.py: Side view now shows a parity-colored tuner circle
    (Ø GEAR_POST_DIA = 15.4 mm) at each string's flat_buffer position.
    Orange = odd string (left plate), blue = even (right plate).
    pedal/tuner_side.svg: redrawn to match user reference guitartuner.png.
    Teardrop-shaped worm driver with Phillips cross + threaded shaft as
    sloped thread ovals. Case, cap, gear post, plywood with callouts. No
    more section hatching.
    pedal/clicky_side.svg: redrawn to match user reference clickypen.jpg.
    Green pusher, translucent gray barrel, pink crenellated cam sleeve,
    blue tri-lobed mounting flange with screw ears, shaft + trapez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
2026-04-22 Finish remaining cleanups + dual-clicky design + regression tests
    build_harp.py:
    - Imports strings.py directly. Three 47-entry tables (_RAW_GEOM,
    _NOTE_SEQUENCE, _STRING_WIDTHS) now derive from STRINGS.
    - NB.y = _c1_sharp_y() + R_BUFFER, derived at runtime. Changing
    R_BUFFER propagates automatically.
    - Added COLUMN_OUTER_X / COLUMN_INNER_X named constants.
    optimize_v2.py:
    - NBO/NBI/ST/BT/NTO derived via inkscape_frame.to_inkscape() from
    bh.NB, g.ST, bulge_tip_point(S_TREBLE_CLEAR), bh.NT.
    - Local U replaced with soundbox.geometry.u. Max drift 0.06 mm (BT.y).
    - v2 closing-cubic control points now read from erand47jc_v2_opt.svg
    at runtime via new _extract_cubics() / _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
2026-04-22 erandapp: use WebViewAssetLoader + force landscape
    WebView blocks fetch() on file:///android_asset/ URLs regardless of
    setAllowFileAccessFromFileURLs. Switched MainActivity to use
    androidx.webkit.WebViewAssetLoader, which serves bundled assets over
    a virtual https://appassets.androidplatform.net/assets/ origin where
    fetch() works same-origin. The app remains fully offline -- no HTTP
    server runs, the origin is synthetic.
    Added implementation 'androidx.webkit:webkit:1.9.0' to app/build.gradle.
    AndroidManifest: screenOrientation landscape (was unspecified). The
    viewer's CSS media query collapses to a 2-column mobile layout at
    <=1300px which conflicts with the .tall panels spanning 2 rows. At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
2026-04-24 Hidden shoulder/base joints + bent round column + vendor schedules
    - Shoulder-chamber and base-chamber joints as hidden tongue-and-groove:
    parameterized in soundbox/geometry.py (SHOULDER_JOINT_*, BASE_JOINT_*),
    documented in soundbox/interfaces.md §1 and §3. Chamber is ONE
    continuous limacon tube from Y_ST_HORIZ to FLOOR_Y; base is an internal
    plug sitting inside it.
    - Column is now a round Ø39 cylinder, gently bent (R=10000 mm, toward
    the strings) with per-face vertical thresholds: inner face goes
    vertical at y=1699.49 (meets soundboard), outer face at y=1755.32.
    Below the thresholds the column slides straight into the base socket.
    - FLOOR_Y raised 1915.5 → 1860 (no foot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
    [force_schedule.csv, hole_schedule.csv]
2026-04-24 Update HANDOFF + regenerate erandharp.txt for 2026-04-23 pass
    HANDOFF.md: new TL;DR covering today's shoulder/base hidden joints,
    bent round column, FLOOR_Y raise, v3-opt canonical neck, and the
    vendor-package scaffolding. Canonical-neck and Open-Questions
    sections updated (v3 supersedes v2; scoop idea for chamber volume
    captured; rotary-prong clicker explicitly on hold; build_step /
    elliptical-hole-cutout / optimize_v2-topology refactor flagged).
    Files-that-matter expanded to include the vendor-package files and
    the interfaces.md / construction.md pointers.
    erandharp.txt: rebuilt for web-claude transport (1.4 MB, 49 files).
    Tightened excludes to drop erandapp/app/build gradle intermediates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
2026-04-24 Base polygon now excludes parabolic scoop region (SVG compound path + evenodd)
    The side-view base polygon is emitted as an SVG compound path with
    fill-rule="evenodd": outer contour is the existing base polygon (CCW),
    inner contour is the scoop silhouette (reversed, so evenodd treats it
    as a hole regardless of winding). The parabola samples above
    Y_TOP_OF_BASE (HW sits ~19 mm into the chamber) are clipped to the line
    y = Y_TOP_OF_BASE via linear interpolation at the down-crossing and
    along the closing chord RIM_FAR -> HW, so the hole contour stays
    entirely inside the base polygon. The scoop silhouette is still drawn
    on top as a stroke-only outline so the parabola and markers remain
    visible; t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
2026-04-24 Add shoulder concave diffuser (R=250, d=15) + raise H_SHOULDER 30->40
    Adds a gentle spherical depression to the shoulder's underside between
    ST and BT as a broadband treble diffuser, and raises H_SHOULDER from
    30 mm to 40 mm so this feature plus the planned BT-local paraboloid
    pocket (sister task) both fit inside the shoulder body.
    - soundbox/geometry.py: new SHOULDER_DIFFUSER_* DESIGN PARAMETERS
    (ENABLED, SPHERE_RADIUS_BASE=250, DEPTH_BASE=15,
    CENTER_XY_BASE=(872.70, 481.94) = midpoint of ST-BT on the rim),
    scaled DERIVED counterparts, and shoulder_diffuser_arc_xy(n_samples)
    helper that returns the z=0 cross-section (sphere centered below rim
    at C=(cx, cy+(R-depth), 0); upper cap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
2026-04-24 Enlarge treble hole Ø140 + add treble2 Ø75 at s'=1475
    Adds SOUND_HOLES_BASE to soundbox/geometry.py (bass/mid/treble/treble2)
    and a derived SOUND_HOLES list with bulge-tip (x, y) positions. The
    treble port grows 100->140 mm for stronger HF radiation; a second
    smaller 75 mm port up by the shoulder (s'=1475) supplies the highest
    band. build_views.py now iterates g.SOUND_HOLES to draw each port on
    the east bulge wall with a labeled circle.
2026-04-24 Add BT-anchored treble paraboloid scoop (r=30, d=12) + raise H_SHOULDER to 40
    Adds a parabolic scoop cut into the shoulder underside, anchored at BT
    (east end of the bulge-tip locus at Y_ST_HORIZ) and aimed at the treble
    sound-hole center. BT is the only rim-chord anchor that keeps the chord
    inside [ST.x, BT.x] on the xy side view. Construction follows the same
    rule as the base scoop: hw + r*perp -> rim_mid, vertex at depth d along
    -axis_u, focus at f = r^2/(4d) along +axis_u. Yields axis tilt ~5.6 deg,
    f = 18.75 mm.
    Introduces a minimal SOUND_HOLES table (with the 'treble' center at
    (829.34, 781.27)) used as the scoop aim point. H_SHOULDER raised from
    30 to 40 mm so the scoop and the forth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
2026-04-24 Carve scoop notch directly into base polygon top edge
    Previous approach (Agent D) emitted the base as an SVG compound path
    with fill-rule="evenodd" and the scoop silhouette clipped to
    Y_TOP_OF_BASE as the inner hole. The clipping flattened the top of the
    scoop near HW (HW sits 19 mm above Y_TOP_OF_BASE, inside the chamber)
    so the rendered scoop looked cut off instead of opening into the
    chamber as designed.
    Replace with a single concave polygon: walk CCW around the base, and
    on the top edge detour through the scoop boundary — chord from the
    top/chord crossing down to RIM_FAR, then parabola back through VERTEX
    up to the top/parabola crossing. The scoop's above-base triangle near
    HW is simp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
2026-04-24 Tilted base top + rear view without column
    - Base polygon top is now a TILTED line coincident with the parabolic
    scoop's rim chord (from HW on the soundboard line down-east to the
    east-bulge intersection), instead of a horizontal line at Y_TOP_OF_BASE
    with a scoop-shaped notch cut into it. Walking CCW around the base:
    HW -> scoop parabola through VERTEX to RIM_FAR -> small bridge to the
    east-bulge/top-plane intersection -> east bulge down to tip_floor ->
    floor west to flat_floor -> implicit close along soundboard to HW.
    The scoop rim is IMPLICITLY part of the base top (they're coincident);
    no more "scoop pokes above base" visual mismatch.
    - Rear view: column strip removed. F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
2026-04-24 Shrink base scoop rim radius to fit inside chamber walls
    Reduce SCOOP_RIM_RADIUS_BASE from 128.25 to 120.75 mm so the entire
    paraboloid rim circle sits inside the limacon chamber. At the previous
    radius, RIM_FAR in the xy side view poked ~9.8 mm east of the east-bulge
    curve at the same y, which would have produced an intersection ridge
    where the scoop punched through the chamber wall in 3D CAD. The new
    radius leaves a ~2.1 mm xy margin to the east bulge and ~18.8 mm z
    margin to the chamber half-width at rim_mid.
    HW (midpoint of CSB_E and C1G) and the centroid (669.12, 1263.30) are
    unchanged; only the rim-circle radius (and derived RIM_FAR / VERTEX /
    FOCUS / FOCAL_LENGTH) are affected.
2026-04-24 Clip shoulder diffuser to ST-BT + render shoulder features on top of strings
    Two side-view cleanups for the treble shoulder region:
    - soundbox/geometry.py: shoulder_diffuser_arc_xy() now clips the raw
    170 mm-wide spherical-cap footprint to x in [ST.x, BT.x] (the
    ~67.85 mm ST-BT chamber-top rim chord), with linear interpolation
    onto the ST.x and BT.x vertical lines at the two crossings. BT.x is
    found locally via binary search on bulge_tip_point, matching the
    pattern used elsewhere. The full y-span of the apex
    (y = Y_ST_HORIZ - 15) is preserved in between.
    - build_views.py (_build_side / side_view_content): moved the SHOULDER
    DIFFUSER and TREBLE SCOOP blocks to the END of the p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
2026-04-24 HANDOFF + erandharp refresh for 2026-04-24 acoustic pass
    HANDOFF.md: new TL;DR at top covering today's acoustic-geometry work.
    Base scoop (paraboloid of revolution) anchored at HW, rim_radius 128.25
    depth 60 aimed at sound-hole centroid; FLOOR_Y_BASE raised 1860 to 1870;
    sound holes resized (treble Ø100 to Ø140, new treble2 Ø75); shoulder
    diffuser (R=250, d=15) plus H_SHOULDER 30 to 40; treble scoop at BT
    (r=30, d=12); tilted base-polygon top coincident with scoop rim chord;
    column removed from rear view (hidden by chamber bulge); CSB_E/CSB_W
    named points added. Acoustic decisions captured: paraboloid wins for
    HF focusing above 1340 Hz (rim diameter 256 mm), sound-hole enlargement
    is the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
2026-04-24 Fix white-stripe silhouette bug + add sound holes to rear view
    Silhouette cap:
    front_view_content and rear_view_content both built upper_y/lower_y by
    iterating sps from bass to treble, then appended a floor-cap point
    indexed from upper_y[-1]. Because the loop ends at S_TREBLE_CLEAR, [-1]
    was the TREBLE-end point (near the top of the chamber, y << FLOOR_Y),
    so the "cap" produced a spurious vertical segment from the chamber's
    treble top straight down to the floor — the visible white stripe in
    the rear view. Corrected to insert(0, ...) at the BASS end (upper_y[0])
    where the bulge tip genuinely sits near FLOOR_Y and needs a floor cap.
    Rear-view sound holes:
    Each hole project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
2026-04-24 Sloped shoulder-footprint clip for diffuser arc
    Previous clip cut the spherical-cap arc at fixed vertical lines x=ST.x
    and x=BT.x, producing vertical walls on the sides of the rendered
    diffuser polygon. Those walls are a rendering artifact — the real 3D
    shoulder body widens as y decreases (west boundary leans along the
    soundboard tangent u; east similar). Replace the hard vertical clip
    with a sloped clip x in [ST.x + slope*dy, BT.x - slope*dy] where
    slope = |u.x/u.y| = 0.625 mm of x per mm of y. Samples outside the
    sloped band are interpolated to the boundary via binary-search along
    the arc segment. Symmetric model — slightly conservative on the east
    side (the actual bulge-tip tangent di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
2026-04-24 Sink shoulder diffuser + treble scoop above tongue joint
    The shoulder-to-chamber tongue-and-groove joint has the chamber's
    tongue rising SHOULDER_JOINT_TONGUE_HEIGHT = 8 mm above Y_ST_HORIZ.
    The diffuser and treble scoop previously had their rim plane at
    Y_ST_HORIZ, meaning they would physically cut through the tongue —
    you can't carve a concave depression where a raised tongue wall
    exists.
    Introduced SHOULDER_FEATURE_CLEARANCE_BASE = 8.0 mm and applied it:
    * SHOULDER_DIFFUSER_CENTER_XY_BASE y: 481.94 -> 473.94
    * TREBLE_SCOOP_HW y: Y_ST_HORIZ -> Y_ST_HORIZ - clearance
    * build_views.py diffuser-rim y uses SHOULDER_DIFFUSER_CENTER_XY[1]
    instead of Y_ST_HORIZ
    After: diffuser apex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
2026-04-24 Add dual-prong toggle research memo (clicky-pen replacement)
    Single-shaft rotary 3-position toggle (flat/nat/sharp) fitting in one
    Ø5 mm hole per string. Solves F7/G7 treble collision where the current
    Ø6.5 mm nat+sharp clicky holes overlap by 3.1 mm in material. Not
    integrated yet — research only.
    See pedal/dual_prong_toggle.md for mechanical principle, geometry,
    actuation, comparison to clicky pen, and integration notes for F7/G7.
2026-04-24 Dual-prong toggle: binary (engaged/not), not 3-state
    Correction per user: the dual-prong toggle is a BINARY mechanism
    (engaged or not engaged), not a 3-position flat/nat/sharp rotary.
    Yoke has two prongs straddling the string at ONE pitch point,
    rotates 90° between REST (yoke parallel to string, passes freely)
    and ENGAGED (yoke perpendicular, prongs press string to the backstop).
    Per string: ONE toggle at the nat pitch point + ONE at the sharp
    point, each independent binary — same combinatorial logic as clicky
    pens. Main win: Ø5 hole instead of Ø6.5 (still 1.6 mm overlap at
    F7/G7 at 3.4 mm spacing, so a 3-position merged toggle may still be
    needed at the very top). Memo rewritten with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
2026-04-24 Toggle memo: pedal-harp disc-capture mechanism, not yoke-press
    Previous memo had the yoke/prongs pressing the string DOWN against a
    backstop. That's wrong. The real pedal-harp mechanism (see
    images/pedal-harp-discs.jpg) has a flat rotating disc with two pegs
    on its face that GRIP the string BETWEEN them -- pegs become the new
    pivot, no backstop needed.
    Rewrite:
    - Disc Ø14 x 1.5 mm on Ø3 axle (was Ø5 shaft)
    - Two Ø1.5 pegs standing 3 mm proud on disc face, 5 mm peg pitch
    - Engagement = rotate ~180° to swing pegs across string lane
    - Binary: pegs straddle (engaged) or clear (disengaged)
    - No axial force, lighter detent (~1.5 N vs ~3 N)
    - Historical precedent: 100+ years of pedal harps us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
2026-04-24 Toggle memo: thumb-wheel actuation (direct disc-rim rotation)
    Per-player feedback, the recommended actuation for the disc toggle is
    direct thumb-wheel rotation of the disc's knurled rim — not a
    push-cam mechanism. The disc protrudes ~3 mm above the plate top edge,
    thumb contacts the rim like a mouse scroll wheel, rolls 180° between
    engaged/disengaged. Fewer parts (no barrel, cam, lever, or shaft),
    fastest gesture, self-evident state, matches pedal-harp prior art.
    Push-cam fallback noted for aesthetic preference only.
2026-04-24 Toggle memo: disc inside gap, axle through plate, knob on outboard face
    Correction per user: the dual-prong disc sits ENTIRELY inside the
    12.7 mm plate gap, with the axle passing through the neck plate via
    the Ø3 hole. The actuation control (Ø12 mm knurled knob) is on the
    OUTBOARD plate face, rotated by the thumb; the axle couples the knob
    rotation to the hidden disc rotation inside the gap.
    Disc diameter reduced to Ø10 mm so it fits cleanly inside the gap
    without interfering with strings or the opposite plate. Pegs project
    3 mm from the disc's inboard face (away from the outboard knob),
    toward the string lane. 180° rotation toggles between engaged and
    disengaged.
    This is the hidden/fl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
2026-04-24 Add ganged disc-lever design: memo + sketch + viewer panel
    - pedal/ganged_disc_lever.md: full design memo for the pedal-harp-style
    hand-pull lever alternative to per-string toggles. 7 hand levers at
    the base of the neck, one per pitch class, each pulling a rigid CF
    rod along the outboard plate face that ganges all discs of that
    class via bell cranks at every pitch point. 50 mm lever travel →
    6.3 mm rod travel → 180° disc rotation. Bistable detent per disc.
    1.3 N peak at lever (8:1 mechanical advantage).
    - pedal/ganged_disc_lever.svg: schematic sketch showing 6 disc stack
    for a single pitch class, rod running along the plate, crank tip
    linkage detail, bell crank pivot at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
2026-04-24 HANDOFF: add 2026-04-24 evening pass (sync to home claude-ai chat)
    Captures: base scoop shrunk to 120.75 to fit chamber; shoulder
    diffuser sloped-clipped to shoulder footprint; features sunk 8 mm
    above tongue joint (SHOULDER_FEATURE_CLEARANCE=8); render order
    swapped (scoop nested inside diffuser); rear-view white-stripe bug
    fixed + sound holes added + column removed.
    Two new pitch-mechanism design memos (research only, not integrated):
    - pedal/dual_prong_toggle.md: disc-capture toggle with hidden disc,
    outboard thumb knob, modeled on real pedal-harp discs.
    - pedal/ganged_disc_lever.md: pedal-harp-style hand-pull levers at
    base, each controlling all strings of one pitch class via a rigi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
2026-04-24 HANDOFF: lock in ganged disc-lever as chosen pitch mechanism
    Decision made 2026-04-24 evening: the Clements 47 pitch-change
    mechanism will be ganged disc-levers (pedal-harp UX, hand-pull
    levers at base of neck, one per pitch class). Clicky pens are
    superseded but not yet removed from the code.
    Integration pending: replace clicky-pen buffers and rendering with
    disc toggles (per-string actuator) + rigid rods on the outboard
    plate face + hand-lever bank at the base. Hole count drops from
    94 × Ø6.5 to 94 × Ø3. Re-check optimize_v2 neck clearance with
    the smaller R_BUFFER.
2026-04-24 Add FreeCAD parametric harp macro
    build_freecad.py builds the full Clements 47 harp as a FreeCAD Part
    document: chamber limacon loft, base plug with parabolic scoop, shoulder
    with spherical diffuser + treble scoop, Ø39 bent round column, two neck
    plates with per-string tuner/clicky holes, four bulge sound holes, and a
    soundboard column ellipse cut. All dimensions read from soundbox.geometry
    so the model regenerates when parameters change. Includes a standalone
    __main__ smoke test (no FreeCAD required) that prints key parameters,
    hole counts, and outline-sample counts for verification.
2026-04-24 Generate erand47.FCStd + enable SAVE_FCSTD in macro
    Ran build_freecad.py headlessly via freecadcmd; it successfully built
    all components (chamber limaçon loft, base plug with scoop, shoulder
    with diffuser + treble scoop, bent round column, neck plates with 133
    drilled holes, four sound holes, soundboard column ellipse) and saved
    the assembly as erand47.FCStd (768 KB).
    Also flipped SAVE_FCSTD from False to True so subsequent runs
    auto-save by default.
    [erand47.FCStd]
2026-04-24 HANDOFF: FreeCAD parametric model landed + tested, .FCStd committed
    Update in-flight FreeCAD section to reflect that build_freecad.py is
    merged on main and erand47.FCStd (768 KB) was generated via freecadcmd
    and committed. All today's work is now on origin/main.
    Documented how to regenerate the .FCStd (headless via freecadcmd with
    a __file__-setting driver, or via FreeCAD GUI macro menu). Listed
    GUESS:-flagged simplifications and deferred items (thin-wall,
    tongue-and-groove, strings, hardware, column-top slot, STEP export).
2026-04-25 Pivot to Josephus 3D-printed lever; deprecate scoop/diffuser; rebuild shoulder; add TechDraw HLR
    Pitch mechanism: switched to Josephus's CC BY-SA 3D-printed harp lever
    (harpcanada.com/3d-lever) as the chosen per-string mechanism. Replaces
    clicky-pen, dual-prong toggle, and ganged disc-lever (all removed).
    3 sizes from the source extended to 5 (XS treble + XL bass) for the
    47-string range. See pedal/lever_3d.md and pedal/lever_3d_*.svg.
    Integration (4 agents in parallel):
    - build_harp.build_strings() adds lever_size, lever_mount_xy,
    bridge_pin_xy, has_lever per string. LEVER_SIZE_TABLE constant.
    Old buffer fields kept (still used by optimize_v2 + neck outline).
    - build_freecad.py + build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
    [erand47.FCStd]
